IgnGGA/cafProyect01/IMAGE/039_analsisProbelmatica.jpeg

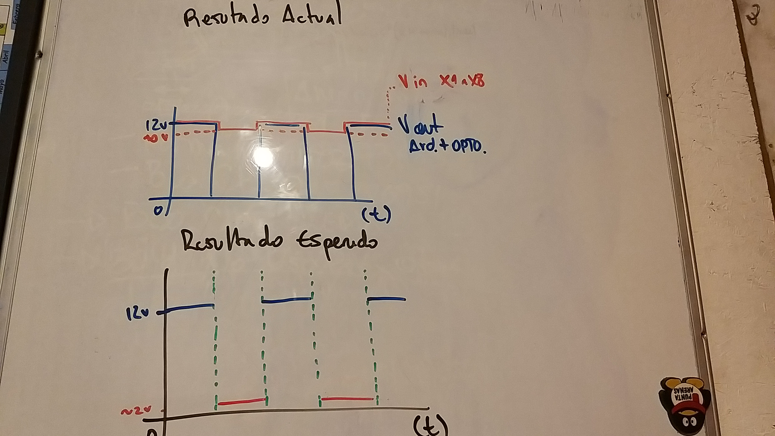
IMAGE/039_analsisProbelmatica.jpeg
