IgnGGA/cafProyect01/EVR_proyecto.pdf

## EVR.CV.VA-X1 EVR.CV.VA-X4 EVR.CV.VA-X5 EVR.CV.VA-X6 EVR.CV.VA-X7 EVR.CV.VA-X8

## Tarjetas internas:

## Ubicación proyecto:

## C:\Users\Ignacio \OneDrive \Documentos\002 _CAF\CAF\Arduino \simPulsosVelocidad_ v2conErrores_v5

Actividad | Status | Actividad | Status
Diseño del programa | 100% | Simulación funcionamiento Placa | 100%
Diseño de la placa | 100% | Placa Impresa y perforada | 100%
Montaje de Componentes | 30% | Funcionamiento de Placa
Desarrollo conexiones VDR | 75% | Montaje de placa en VDR
Funcionamiento | | Modificación_1 | Cambio del Diseño de Placa (versión 2)
Modificación_2 | | Modificación_3

## Revisión

## El Arduino queda pegado y no carga sketch nuevos, probablemente Hayan problemas en el microprocesador que ocasionan problemas en la carga

Sol1: Cambiar Microprocesador.
Sol2: Reemplazar placa completa Arduino.
Sol3: Buscar ayudas y soluciones en foros de internet respecto al error.

De nuevos sketch. (09/04/2021).

## Sol2 fue la última aplicada, la placa se quemó en la comunicación con el computador, por ende no permite modificar el integrado o ver los datos seriales en el computador, la placa solo quedo disponible para arrancar programas sin la necesidad de conectarlo a un computador, es decir, su

funcionamiento caer en solo ejecutar programas sin comunicación alguna.

## Prueba en Protoboard con optoacopladores:

# 001 Registrador de Eventos

8 de abril de 2021 13:14

EVR_proyecto página 1

23/04: los transistores 2N2222 conmutan como corresponde, pero los optoacopladores no realizan dicha acción
tan vez se deba al tipo de componente, su arquitectura u otra característica (PRESENCIA DE CORTE EN PISTA DE TIERRA LO QUE CAUSABA EL ERROR EN EL CIRCUITO).

# 002 Notas de avance

## 23 de abril de 2021 9:38

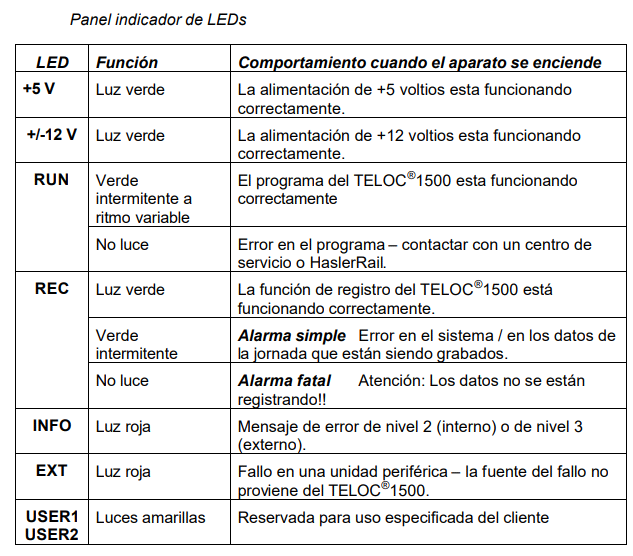
[picture p10: figure]

b4 >>

## z4 << EVR.CV.VA-X11-a3(POSUB)

b2 >>

## z2 << EVR.CV.VA-X11-a3(POSUB) b32(ID0) -- b30(ID_HI)

## EVR.CV.VA-X7

## GND >> tierra b30(GND) >> GND Sensor d28(sig. A) >> Señal Sensor 1 d30(+12v) >> EVR.CV.VA-X1-d6(AN2+) b2(ID1_0) -- z2(ID1_GND) b32(ID2_9) -- z32(ID2_GND)

## EVR.CV.VA-X8

b4 >>

## z4 << EVR.CV.VA-X11-a3(POSUB)

b2 >>

## z2 << EVR.CV.VA-X11-a3(POSUB) d32(ID0) -- b30(ID_HI)

## EVR.CV.VA-X6

## b2(ID1) -- z6(ID_HI)

## EVR.CV.VA-X5

## GND >> tierra d8(AN1+) >> EVR.CV.VA-X1-z10(AN2-) d10(AN1-) >> +12v del Sensor b8(AINI2) -- d10(AINI2-) b4(GND) >> GND Sensor d6(sig. A) >> Señal Sensor 2 d2(ID0) -- z6(ID_HI)

## EVR.CV.VA-X4

## d6(AN2+) << EVR.CV.VA-X8-d30(+12) z10(AN2-) << EVR.CV.VA-X4-d8(AN1+) b6 -- z8 [PUENTE] GND >> tierra z10(GND) >> GND Sensor 3 b8(sig. A) >> Señal Sensor 3 z8(+12v) >> Vcc Sensor 3

z28 >>

## d28 << EVR.CV.VA-X11-a3(POSUB)

z26 >>

## d26 >> EVR.CV.VA-X11-a3(POSUB)

## EVR.CV.VA-X1

## DIJN3--LUZ-DERECHA --CIERRE DE PUERTA DIJNE--LUZ-IZQUIERDA--CC

# 003 Análisis Tarjetas del VDR

## 8 de abril de 2021 15:14

//---
DEFINICION_PINES--------------------------------------------------------------------------------------------------------------------
int pulseOut = 3; | //salida pulsos que simulan velocidad, se selecciona el pin11 por sus
cualidades de salida PWM
int luz = 4; | //indicador que representa LUZ indicadora del TREN
int sirena = 5; | //indicador que representa la SIRENA o GRABACIÓN del tren
int puerta = 6; | //indicador que representa las PUERTAS del TREN
int X1_VT_6 = 10; | //lectura de variable provimiente de tarjeta X1 para rele control de velocidad
6
int X1_VT_05 = 7; | //lectura de variable provimiente de tarjeta X1 para rele control de velocidad
05
int X7_VT_6 =11; | //lectura de variable provimiente de tarjeta X7 para rele control de velocidad
6
int X7_VT_05 = 8; | //lectura de variable provimiente de tarjeta X7 para rele control de velocidad
05
int X6_VT_6 = 12; | //lectura de variable provimiente de tarjeta X6 para rele control de velocidad
6
int X6_VT_05 = 9; | //lectura de variable provimiente de tarjeta X6 para rele control de velocidad
05
int error = 13; | //variable destinada a dar indicación de ERROR a causa de alguna condición
incumplida
//---
DEFINICION_VARIABLES----------------------------------------------------------------------------------------------------------------
int countMax = 1160; | //es 1.25 veces la frecuencia maxima
float tiempo; | //tiempo que estara en funcion de la freciencia
float i, j; | //contadores
float vel; | //valor de la velocidad en funcion de la frecuencia
const float vel_1 = 0.5; | //velocidad para apagar el rele 1
const float vel_2 = 6; | //velocidad para apagar el rele 2
const int z = 100; | //ventanas de la rueda
const float var1 = 0.953; | //diametro de la rueda en metros
const float var2 = 3.6; | //constante de velocidad del TREN
const float var3 = 100; | //ventanas de la rueda

void setup() {
Serial.begin(9600); | //velocidad de lectura y escritura del arduino.
pinMode(pulseOut, OUTPUT);
pinMode(puerta, OUTPUT);
pinMode(luz, OUTPUT);
pinMode(sirena, OUTPUT);
pinMode(X1_VT_6, INPUT); | //se define como entrada para lectura de reaccion del REGISTRADOR
DE EVENTOS
pinMode(X1_VT_05, INPUT); | //se define como entrada para lectura de reaccion del REGISTRADOR
DE EVENTOS
pinMode(X7_VT_6, INPUT);
pinMode(X7_VT_05, INPUT);
pinMode(X6_VT_6, INPUT);
pinMode(X6_VT_05, INPUT);
pinMode(error, OUTPUT);
}

void loop() {
digitalWrite(puerta, HIGH); Serial.println("TREN sale de ESTACIÓN"); acelerar();
Serial.println("VELOCIDAD MAXIMA"); desacelerar();
Serial.println("TREN ha llegado a DESTINO");
enEstacion();
}
//------------FUNCIONES-------------------------------------------------------------------------------//---SALIDA_SEÑAL_CUADRADA----------------------------------------------------------------------------
void senalOut() { | //Funcion que se encarga de generar los estados de los semiciclos
correspondientes.
tiempo = (1000 / (i / (1.25))); //tiempo de duracion de cada semiCiclo en milisegundos digitalWrite(pulseOut, HIGH);
delay(tiempo / 2); | //semiciclo positivo
digitalWrite(pulseOut, LOW);
delay(tiempo / 2); | //semiciclo negativo

}
//---ACELERACION_DEL_TREN-----------------------------------------------------------------------------
void acelerar() {
for (i = 1; i < countMax; i++) { //se calculo que aproximadamente los 928hz se alcanzan los 100km/h senalOut();
velMax();
lecturasEnSubida05();
lecturasEnSubida6();
}
}
//---DESACELERACION_DEL_TREN--------------------------------------------------------------------------void desacelerar() {
for (i = countMax; i >= 1; i--) {
senalOut();

### Cambiar algunas variables globales a locales no funciono, sigue utilizando más del 80% de memoria para dichas variables

# 004 Programa Arduino

8 de abril de 2021 15:16

velMax();
lecturasEnBajada6();
lecturasEnBajada05();
}
}
//---VISUALIZAR_VELOCIDAD-----------------------------------------------------------------------------void velMax() {
vel = ((i / 1.25) * PI * var1 * var2 / z);
Serial.println(vel);
}
//---ACCIONES_EN_ESTACION-----------------------------------------------------------------------------void enEstacion() {
digitalWrite(puerta, LOW);
Serial.println("APERTURA DE PUERTAS");
delay(4500);
digitalWrite(luz, HIGH);
Serial.println("Se enciende indicador Luminoso"); delay(2000);
digitalWrite(sirena, HIGH);
Serial.println("Suena la Sirena");
delay(2500);
digitalWrite(sirena, LOW); Serial.println("Deja de sonal Sirena"); digitalWrite(luz, LOW);
Serial.println("Se apaga luz indicadora"); digitalWrite(puerta, HIGH); Serial.println("CIERRE DE PUERTAS");
delay(1000);
}
//---FUNCIONES_POR_ERRORES----------------------------------------------------------------------------void error_001() { //error 1 cuando X1_VT_05 debiera ser HIGH
Serial.println("");
for (;;) {
digitalWrite(error, HIGH);
delay(500);
digitalWrite(error, LOW);
delay(500);
}
}
void error_002() { //error 2 cuando X1_VT_6 deberia ser HIGH for (;;) {
for (j = 0; j < 2; j++) {
digitalWrite(error, HIGH);
delay(500);
digitalWrite(error, LOW);
delay(500);
}
delay(1000);
}
}
void error_003() { //error 3 cuando X7_VT_05 deberia ser HIGH for (;;) {
for (j = 0; j < 3; j++) {
digitalWrite(error, HIGH);
delay(500);
digitalWrite(error, LOW);
delay(500);
}
delay(1000);
}
}
void error_004() { //error 4 cuando X7_VT_6 deberia ser HIGH for (;;) {
for (j = 0; j < 4; j++) {
digitalWrite(error, HIGH);
delay(500);
digitalWrite(error, LOW);
delay(500);
}
delay(1000);
}
}
void error_005() { //error 5 cuando X6_VT_05 deberia ser HIGH for (;;) {
for (j = 0; j < 5; j++) {
digitalWrite(error, HIGH);
delay(500);
digitalWrite(error, LOW);
delay(500);
}
delay(1000);
}
}
void error_006() { //error 6 cuando X6_VT_6 deberia ser HIGH for (;;) {
for (j = 0; j < 6; j++) {
digitalWrite(error, HIGH);
delay(500);
digitalWrite(error, LOW);
delay(500);
}
delay(1000);

}
}
void error_007() { //error 7 Ninguna lectura cambia for (;;) {
for (j = 0; j = 7; j++) {
digitalWrite(error, HIGH);
delay(500);
digitalWrite(error, LOW);
delay(500);
}
delay(1000);
}
}
//---
LECTURAS----------------------------------------------------------------------------------------------------------------------------- --------------
void lecturasEnSubida05() {
Serial.println(digitalRead(X1_VT_05));
Serial.println(digitalRead(X7_VT_05));
Serial.println(digitalRead(X6_VT_05));
while (vel > vel_1) { | //Cuando la velocidad calculada es MAYOR a 0.5KM/h y...
if (digitalRead(X1_VT_05) == LOW ) { | //Si la lectura es 0 digital, se ejecuta el error 1
Serial.println("ERROR_011: la variable X1_VT_05 debia arrojar un UNO, pero recibio un CERO\nERROR CONTROL DE VELCIDAD RELE 0.5KM/H");
error_001();
break;
}
else if (digitalRead(X7_VT_05) == LOW ) { //Si la lectura es 0 digital, se ejecuta el error 3 Serial.println("ERROR_021: la variable X7_VT_05 debia arrojar un UNO, pero recibio un CERO\nERROR CONTROL DE VELCIDAD RELE 0.5KM/H");
error_003();
break;
}
else if (digitalRead(X6_VT_05) == LOW ) { //Si la lectura es 0 digital, se ejecuta el error 5 Serial.println("ERROR_031: la variable X6_VT_05 debia arrojar un UNO, pero recibio un CERO\nERROR CONTROL DE VELCIDAD RELE 0.5KM/H");
error_005();
break;
}
else{
break;
}
break;
}
}
void lecturasEnSubida6(){
Serial.println(digitalRead(X1_VT_6));
Serial.println(digitalRead(X7_VT_6));
Serial.println(digitalRead(X6_VT_6));
while (vel > vel_2) { | //Cuando la velocidad calculada es MENOR a 6km/h y...
if (digitalRead(X1_VT_6) == LOW) { | //Si la lectura es 1 digital, se ejecuta el error 2
Serial.println("ERROR_012: la variable X1_VT_6 debia arrojar un UNO, pero recibio un CERO\nERROR CONTROL DE VELCIDAD RELE 6KM/H");
error_002();
break;
}
else if (digitalRead(X7_VT_6) == LOW) { | //Si la lectura es 1 digital, se ejecuta el error 4
Serial.println("ERROR_022: la variable X7_VT_6 debia arrojar un UNO, pero recibio un CERO\nERROR CONTROL DE VELCIDAD RELE 6KM/H");
error_004();
break;
}
else if (digitalRead(X6_VT_6) == LOW) { | //Si la lectura es 1 digital, se ejecuta el error 6
Serial.println("ERROR_032: la variable X6_VT_6 debia arrojar un UNO, pero recibio un CERO\nERROR CONTROL DE VELCIDAD RELE 6KM/H");
error_006();
break;
}
else{
break;
}
break;
}
}
void lecturasEnBajada05() { Serial.println(digitalRead(X1_VT_05));
Serial.println(digitalRead(X7_VT_05));
Serial.println(digitalRead(X6_VT_05));
while (vel <= vel_1) { | //Si la velocidad calculada es MENOR a 0.5KM/h y...
if (digitalRead(X1_VT_05) == HIGH ) { | //Si la lectura es 1 digital, se ejecuta el error 1
Serial.println("ERROR_013: la variable X1_VT_05 debia arrojar un CERO, pero recibio un UNO\nERROR CONTROL DE VELCIDAD RELE 0.5KM/H");
error_001();
break;
}
else if (digitalRead(X7_VT_05) == HIGH ) { | //Si la lectura es 1 digital, se ejecuta el error 3
Serial.println("ERROR_023: la variable X7_VT_05 debia arrojar un CERO, pero recibio un UNO\nERROR CONTROL DE VELCIDAD RELE 0.5KM/H");
error_003();
break;
}
else if (digitalRead(X6_VT_05) == HIGH ) { | //Si la lectura es 1 digital, se ejecuta el error 5

Serial.println("ERROR_033: la variable X6_VT_05 debia arrojar un CERO, pero recibio un UNO\nERROR CONTROL DE VELCIDAD RELE 0.5KM/H");
error_005();
break;
}
else{
break;
}
break;
}
}
void lecturasEnBajada6(){
Serial.println(digitalRead(X1_VT_6));
Serial.println(digitalRead(X7_VT_6));
Serial.println(digitalRead(X6_VT_6));
while (vel <= vel_2) { | //Si la velocidad calculada es MENOR a 6km/h y...
if (digitalRead(X1_VT_6) == HIGH) { | //Si la lectura es 1 digital, se ejecuta el error 2
Serial.println("ERROR_014: la variable X1_VT_6 debia arrojar un CERO, pero recibio un UNO\nERROR CONTROL DE VELCIDAD RELE 6KM/H");
error_002();
break;
}
else if (digitalRead(X7_VT_6) == HIGH) { | //Si la lectura es 1 digital, se ejecuta el error 2
Serial.println("ERROR_024: la variable X7_VT_6 debia arrojar un CERO, pero recibio un UNO\nERROR CONTROL DE VELCIDAD RELE 6KM/H");
error_004();
break;
}
else if (digitalRead(X6_VT_6) == HIGH) { | //Si la lectura es 1 digital, se ejecuta el error 2
Serial.println("ERROR_034: la variable X6_VT_6 debia arrojar un CERO, pero recibio un UNO\nERROR CONTROL DE VELCIDAD RELE 6KM/H");
error_006();
break;
}
else{
break;
}
break;
}
}
//---NOTAS--------------------------------------------------------------------------------------------
//considerar que la grafica de velocidad que se dibuja (o comprende) es lineal, por lo tanto, su aceleración es constante mientras que a travez
//de una ecuacion de posición en funcion del tiempo es parabolico, esto considerando el M.R.U.A. (movimiento rectilineo uniforme acelerado).
//El tiempo aproximado desde la salida del tren hasta la llegada a la estacion toma aproximadamente 1:09 minutos.
//Se cambio la proporcion de la frecuencia de 2.5 a 1.25 veces la frecuencia, esto debido a que el programa toma mas tiempo en las iteraciones.
//los casos de errores evalua una tarjeta a la vez, queda pendiente versionar casos de pruebas para multiples combinaciones de tarjetas.

//---
DEFINICION_PINES--------------------------------------------------------------------------------------------------------------------

# int error = 2; //variable destinada a dar indicación de ERROR a causa de alguna condición incumplida

int pulseOut = 3; //salida pulsos que simulan velocidad, se selecciona el pin11 por sus cualidades de

# salida PWM

int cc = 4; | //Confirmación Cierre de Puertas.
int luz = 5; | //indicador que representa LUZ indicadora del TREN

# int sirena = 6; //indicador que representa la SIRENA o GRABACIÓN del tren int puerta = 7; //indicador que representa las PUERTAS del TREN

int X1_VT_6 = 8; //lectura de variable provimiente de tarjeta X1 para rele control de velocidad 6 int X7_VT_6 = 9; //lectura de variable provimiente de tarjeta X7 para rele control de velocidad 6 int X6_VT_6 = 10; //lectura de variable provimiente de tarjeta X6 para rele control de velocidad 6 int X1_VT_05 = 11; //lectura de variable provimiente de tarjeta X1 para rele control de velocidad 05 int X7_VT_05 = 12; //lectura de variable provimiente de tarjeta X7 para rele control de velocidad 05 int X6_VT_05 = 13; //lectura de variable provimiente de tarjeta X6 para rele control de velocidad 05 //---
DEFINICION_VARIABLES----------------------------------------------------------------------------------------------------------------
int countMax = 1160; | //es 1.25 veces la frecuencia maxima
float tiempo; | //tiempo que estara en funcion de la freciencia
float i, j; | //contadores
float vel; | //valor de la velocidad en funcion de la frecuencia

const float vel_1 = 0.5; //velocidad para apagar el rele 1 const float vel_2 = 6; //velocidad para apagar el rele 2 const float var1 = 0.953; //diametro de la rueda en metros const float var2 = 3.6; //constante de velocidad del TREN const float var3 = 100; //ventanas de la rueda const float var4 = 1.25; //Cantidad de veces que se multiplico la frecuencia maxima

# void setup()

{
Serial.begin(9600); //velocidad de lectura y escritura del arduino. pinMode(pulseOut, OUTPUT);
pinMode(puerta, OUTPUT);
pinMode(luz, OUTPUT);
pinMode(sirena, OUTPUT);
pinMode(X1_VT_6, INPUT); //se define como entrada para lectura de reaccion del REGISTRADOR

# DE EVENTOS

pinMode(X1_VT_05, INPUT); //se define como entrada para lectura de reaccion del REGISTRADOR

# DE EVENTOS

pinMode(X7_VT_6, INPUT);
pinMode(X7_VT_05, INPUT);
pinMode(X6_VT_6, INPUT);
pinMode(X6_VT_05, INPUT);
pinMode(error, OUTPUT);

# pinMode(A0, OUTPUT); //Se usaran las entradas analogicas como salidas digitales

pinMode(A1, OUTPUT);
pinMode(A2, OUTPUT);
pinMode(A3,OUTPUT);

# 0041 Programa Arduino (Actual)

## 26 de abril de 2021 13:17

}

# void loop()

{
digitalWrite(cc, LOW);
enEstacion();
Serial.println("TREN sale de ESTACIÓN"); acelerar();
Serial.println("VELOCIDAD MAXIMA"); desacelerar();
Serial.println("TREN ha llegado a DESTINO");
}
//------------FUNCIONES-------------------------------------------------------------------------------//---SALIDA_SEÑAL_CUADRADA----------------------------------------------------------------------------

# void senalOut()

{ | //Funcion que se encarga de generar los estados de los semiciclos
correspondientes.
| tiempo = (1000 / (i / (var4))); //tiempo de duracion de cada semiCiclo en milisegundos
| digitalWrite(pulseOut, HIGH);
| delay(tiempo / 2); //semiciclo positivo
| digitalWrite(pulseOut, LOW);
| delay(tiempo / 2); //semiciclo negativo
}
//---ACELERACION_DEL_TREN-----------------------------------------------------------------------------

# void acelerar()

{
| for (i = 1; i < countMax; i++)
| { //se calculo que aproximadamente los 928hz se alcanzan los 100km/h
senalOut();
velMax();
| lecturasEnSubida05();
| lecturasEnSubida6();
}
}
//---DESACELERACION_DEL_TREN--------------------------------------------------------------------------

# void desacelerar()

{
| for (i = countMax; i >= 1; i--)
{
senalOut();
velMax();
| lecturasEnBajada6();
| lecturasEnBajada05();
}
}
//---VISUALIZAR_VELOCIDAD-----------------------------------------------------------------------------

# void velMax()

{
| vel = ((i / var4) * PI * var1 * var2 / var3);
Serial.println(vel);
}
//---ACCIONES_EN_ESTACION-----------------------------------------------------------------------------

# void enEstacion()

{
| digitalWrite(puerta, LOW);
| Serial.println("APERTURA DE PUERTAS");
delay(4500);

digitalWrite(luz, HIGH);
Serial.println("Se enciende indicador Luminoso"); delay(2000);
digitalWrite(sirena, HIGH);
Serial.println("Suena la Sirena");
delay(2500);
digitalWrite(sirena, LOW); Serial.println("Deja de sonal Sirena"); digitalWrite(luz, LOW);
Serial.println("Se apaga luz indicadora"); digitalWrite(puerta, HIGH); Serial.println("CIERRE DE PUERTAS"); digitalWrite(cc, HIGH);
delay(1000);
}
//---FUNCIONES_POR_ERRORES----------------------------------------------------------------------------

# void error_001() { //error 1 cuando X1_VT_05 debiera ser HIGH

Serial.println("");

# for (;;)

{
digitalWrite(error, HIGH); delay(500);
digitalWrite(error, LOW);
delay(500);
}
}

# void error_002() { //error 2 cuando X1_VT_6 deberia ser HIGH for (;;)

{

# for (j = 0; j < 2; j++)

{
digitalWrite(error, HIGH); delay(500);
digitalWrite(error, LOW);
delay(500);
}
delay(1000);
}
}

# void error_003() { //error 3 cuando X7_VT_05 deberia ser HIGH for (;;)

{

# for (j = 0; j < 3; j++)

{
digitalWrite(error, HIGH); delay(500);
digitalWrite(error, LOW);
delay(500);
}
delay(1000);
}
}

# void error_004() { //error 4 cuando X7_VT_6 deberia ser HIGH

# for (;;)

{

# for (j = 0; j < 4; j++)

{
digitalWrite(error, HIGH); delay(500);
digitalWrite(error, LOW);
delay(500);
}
delay(1000);
}
}

# void error_005() { //error 5 cuando X6_VT_05 deberia ser HIGH for (;;)

{

# for (j = 0; j < 5; j++)

{
digitalWrite(error, HIGH); delay(500);
digitalWrite(error, LOW);
delay(500);
}
delay(1000);
}
}

# void error_006() { //error 6 cuando X6_VT_6 deberia ser HIGH for (;;)

{

# for (j = 0; j < 6; j++)

{
digitalWrite(error, HIGH); delay(500);
digitalWrite(error, LOW);
delay(500);
}
delay(1000);
}
}

# void error_007() { //error 7 Ninguna lectura cambia for (;;)

{

# for (j = 0; j = 7; j++)

{
digitalWrite(error, HIGH); delay(500);
digitalWrite(error, LOW);
delay(500);
}
delay(1000);
}
}
//---
LECTURAS-------------------------------------------------------------------------------------------------------------------------------------------

# void lecturasEnSubida05()

{
Serial.println(digitalRead(X1_VT_05)); Serial.println(digitalRead(X7_VT_05)); Serial.println(digitalRead(X6_VT_05));

# while (vel > vel_1)

{ //Cuando la velocidad calculada es MAYOR a 0.5KM/h y...

# if (digitalRead(X1_VT_05) == HIGH) { //Si la lectura es 0 digital, se ejecuta el error 1

digitalWrite(A0,HIGH);
digitalWrite(A1,LOW);
digitalWrite(A2,LOW);
digitalWrite(A3,LOW);
Serial.println("ERROR_011: la variable X1_VT_05 debia arrojar un UNO, pero recibio un CERO \nERROR CONTROL DE VELCIDAD RELE 0.5KM/H");
error_001();
break;
}

# else if (digitalRead(X7_VT_05) == HIGH) { //Si la lectura es 0 digital, se ejecuta el error 3

digitalWrite(A0,LOW);
digitalWrite(A1,HIGH);
digitalWrite(A2,LOW);
digitalWrite(A3,LOW);
Serial.println("ERROR_021: la variable X7_VT_05 debia arrojar un UNO, pero recibio un CERO \nERROR CONTROL DE VELCIDAD RELE 0.5KM/H");
error_003();
break;
}

# else if (digitalRead(X6_VT_05) == HIGH) { //Si la lectura es 0 digital, se ejecuta el error 5

digitalWrite(A0,HIGH);
digitalWrite(A1,HIGH);
digitalWrite(A2,LOW);
digitalWrite(A3,LOW);
Serial.println("ERROR_031: la variable X6_VT_05 debia arrojar un UNO, pero recibio un CERO \nERROR CONTROL DE VELCIDAD RELE 0.5KM/H");
error_005();
break;
}

# else

{
break;
}
break;
}
}

# void lecturasEnSubida6()

{
Serial.println(digitalRead(X1_VT_6)); Serial.println(digitalRead(X7_VT_6)); Serial.println(digitalRead(X6_VT_6));

# while (vel > vel_2)

{ //Cuando la velocidad calculada es MENOR a 6km/h y...

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

# aceleración es constante mientras que a travez

//de una ecuacion de posición en funcion del tiempo es parabolico, esto considerando el M.R.U.A. (movimiento rectilineo uniforme acelerado).

# //El tiempo aproximado desde la salida del tren hasta la llegada a la estacion toma

aproximadamente 1:09 minutos.
//Se cambio la proporcion de la frecuencia de 2.5 a 1.25 veces la frecuencia, esto debido a que el programa toma mas tiempo en las iteraciones.
//los casos de errores evalua una tarjeta a la vez, queda pendiente versionar casos de pruebas para multiples combinaciones de tarjetas.

# 005 Proteus

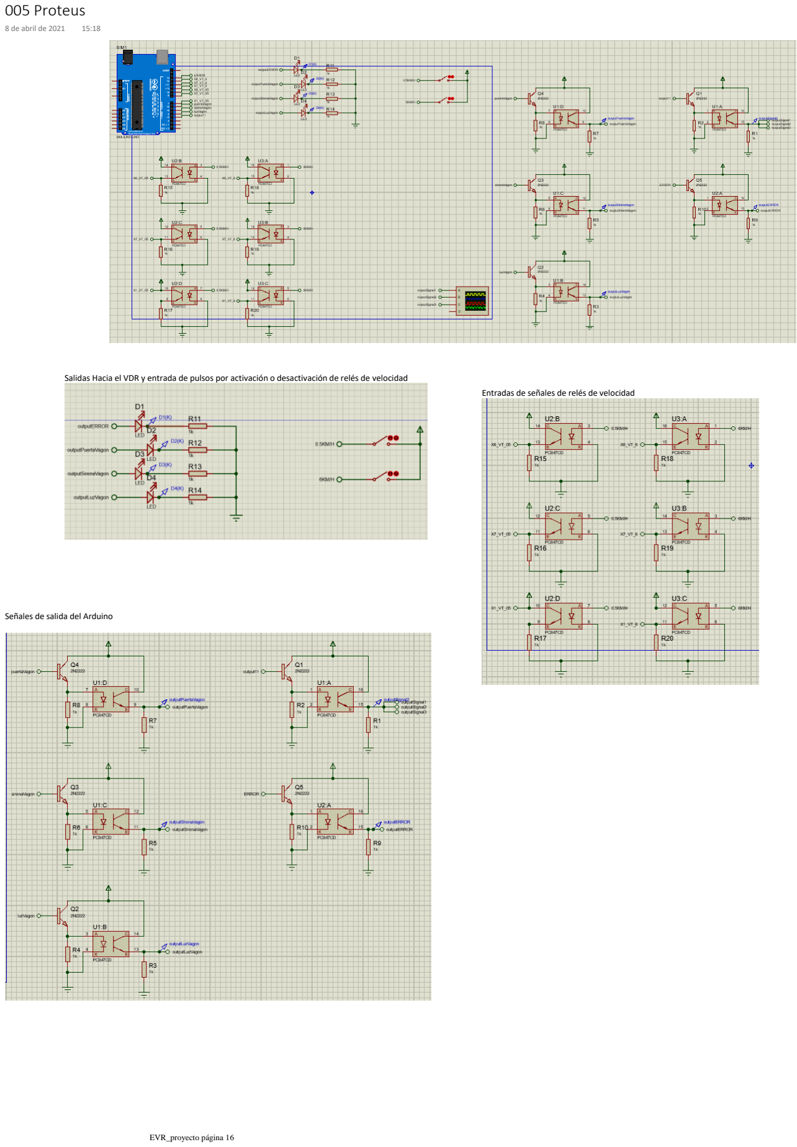
[picture p11: page 16]

Salidas Hacia el VDR y entrada de pulsos por activación o desactivación de relés de velocidad Entradas de señales de relés de velocidad

Señales de salida del Arduino

8 de abril de 2021 15:18

## 006 Diseño PCB

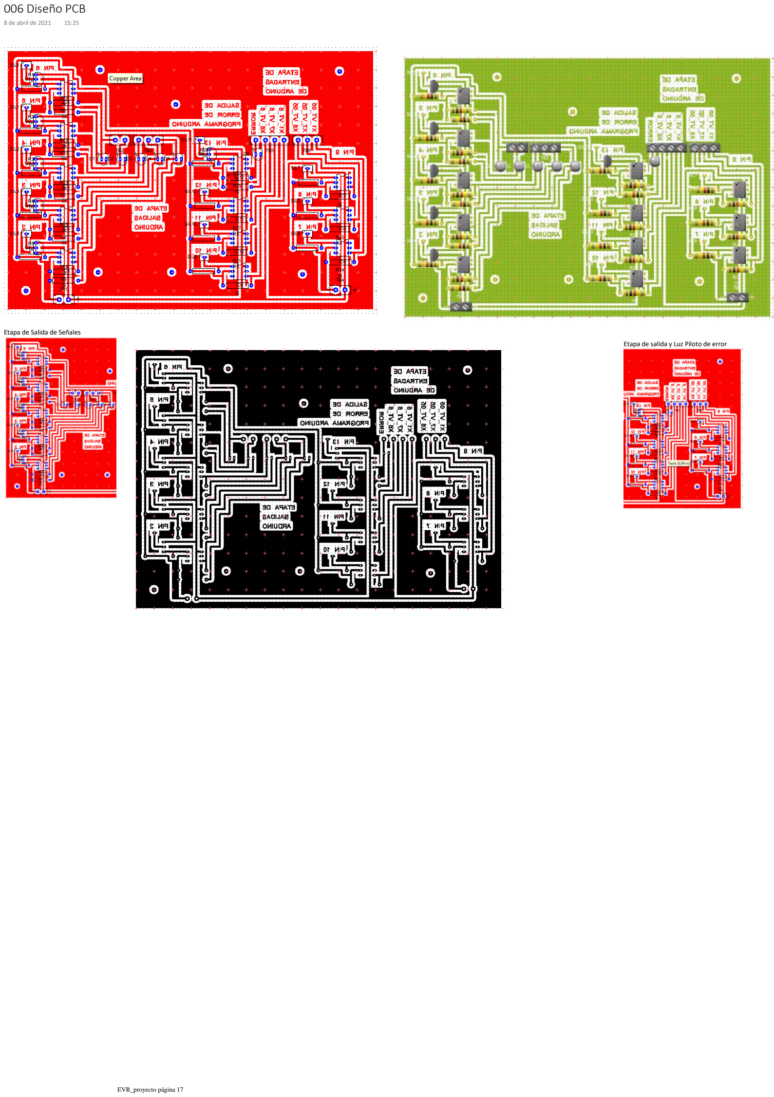
[picture p12: page 17]

Etapa de Salida de Señales Etapa de salida y Luz Piloto de error

8 de abril de 2021 15:25

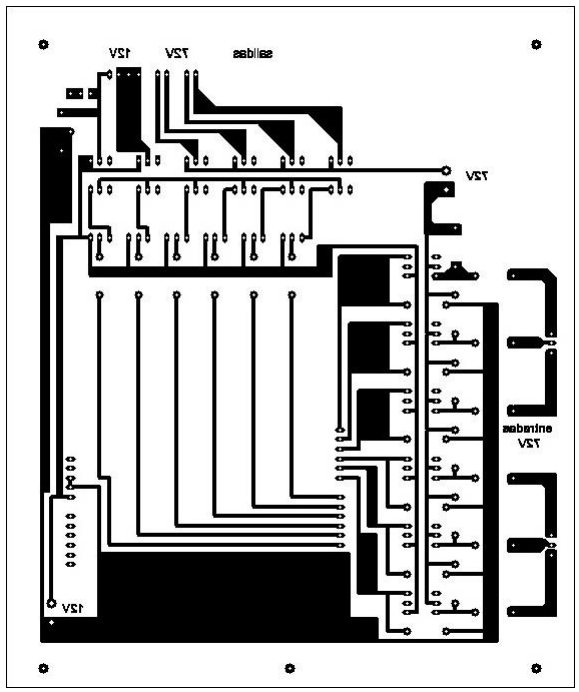
[picture p13: figure]

Detalle: Falta relacionar las tierras, de los optoacopladores en la etapa de salida y la tierra de la etapa de control (+12V).

# 0061 Diseño PCB (Actual)

## 26 de abril de 2021 13:08

### Estará condicionado por la respuesta del Arduino… ¿Qué respuesta necesito por parte del Arduino para saber que error proyectar? ¿Qué necesito que reciba el pic para proyectar el error?

### Proyectar mensaje de error dependiendo de qué y en qué momento…

Actividad | Estatus | Solución/problema
Programa para PIC 16F628A | ok
Prueba Simulación Display | ok
Carga de programa en PIC FISICO | Ok | Utilización de PICKIT3 programer para subir el programa
Prueba del sistema | Ok | El programa aunque aparentemente está cargado, no se ejecuta al energizar. Sol: problemas de alimentación, el programa se ejecuta sin problemas y responde a los estímulos establecidos

### Diseño de PCB/ Impresión/ Montaje

Prueba en conjunto Arduino | | Funciona correctamente según las combinaciones provenientes del ARDUINO. En primera fase.

# 007 ¿Qué hacer con el pic 16f628A?

14 de abril de 2021 11:01

#include <16F628A.h>

#use delay(clock = 4000000) | /* OSCILADOR INTERNO */ | //No aplica, ya que se activo el cristal interno

#FUSES NOWDT | /* No Watch Dog Timer*/

//#FUSES HS | /* High speed Osc (> 4mhz)*/ | //Se usa con un cristal mayor al de 4Mhz, se
recomienda usar el cristal interno
#FUSES PUT | /* Power Up Timer*/

#FUSES NOPROTECT | /* Code not protected from reading*/

#FUSES NOBROWNOUT | /* No brownout reset*/

#FUSES NOMCLR | /* Master Clear pin disabled*/

#FUSES NOLVP | /* No low voltage prgming, B3(PIC16) or B5(PIC18) used for I/O*/

#FUSES NOCPD

#FUSES INTRC | //Activacion uso cristal interno

#include <lcd.c> | /*libreria para usar el lcd*/

#define LCD_ENABLE_PIN PIN_B0 /* ASIGNAMOS EL PIN "B0" COMO SALIDA PARA E */ #define LCD_RS_PIN PIN_B1 /* ASIGNAMOS EL PIN "B1" COMO SALIDA PARA RS*/ #define LCD_RW_PIN PIN_B2 /* ASIGNAMOS EL PIN "B2" COMO SALIDA PARA RW*/

#define LCD_DATA4 PIN_B4 | /* ASIGNAMOS EL PIN "B4" COMO SALIDA PARA D4*/

#define LCD_DATA5 PIN_B5 | /* ASIGNAMOS EL PIN "B5" COMO SALIDA PARA D5*/

#define LCD_DATA6 PIN_B6 | /* ASIGNAMOS EL PIN "B6" COMO SALIDA PARA D6*/

#define LCD_DATA7 PIN_B7 | /* ASIGNAMOS EL PIN "B7" COMO SALIDA PARA D7*/

void main() {

output_high(pin_a4);
delay_ms(500);
output_low(pin_a4);
lcd_init();
lcd_putc("

\f");
do{
lcd_gotoxy(1,1);
printf(lcd_putc,"Esperando ERROR"); lcd_gotoxy(1,2);
printf(lcd_putc, "Registrador de Eventos");
//funcion de arduino lecturasEnSubida05
if (input(PIN_A0) == 1 && input(PIN_A1)==0 && input(PIN_A2)==0 && input(PIN_A3)==0) {
| lcd_putc(" \f"); lcd_gotoxy(1,1); printf(lcd_putc, "Error en:"); lcd_gotoxy(1,2); printf(lcd_putc,"ERROR_011: la variable X1_VT_05"); break;

}
else if (input(PIN_A0) == 0 && input(PIN_A1)==1 && input(PIN_A2)==0 && input(PIN_A3)==0) {
| lcd_putc(" \f"); lcd_gotoxy(1,1); printf(lcd_putc, "Error en:"); lcd_gotoxy(1,2); printf(lcd_putc, "ERROR_021: la variable X7_VT_05"); break;

}
else if (input(PIN_A0) == 1 && input(PIN_A1)==1 && input(PIN_A2)==0 && input(PIN_A3)==0) {
| lcd_putc(" \f"); lcd_gotoxy(1,1); printf(lcd_putc, "Error en:"); lcd_gotoxy(1,2); printf(lcd_putc, "ERROR_031: la variable X6_VT_05"); break;

}
//funcion de arduino lecturasEnSubida6
else if (input(PIN_A0) == 0 && input(PIN_A1)==0 && input(PIN_A2)==1 && input(PIN_A3)==0) {
| lcd_putc(" \f"); lcd_gotoxy(1,1); printf(lcd_putc, "Error en:"); lcd_gotoxy(1,2); printf(lcd_putc,"ERROR_012: la variable X1_VT_6"); break;

}
else if (input(PIN_A0) == 1 && input(PIN_A1)==0 && input(PIN_A2)==1 && input(PIN_A3)==0) {
| lcd_putc(" \f"); lcd_gotoxy(1,1); printf(lcd_putc, "Error en:"); lcd_gotoxy(1,2); printf(lcd_putc, "ERROR_022: la variable X7_VT_6"); break;

}
else if (input(PIN_A0) == 0 && input(PIN_A1)==1 && input(PIN_A2)==1 && input(PIN_A3)==0) {
| lcd_putc(" \f"); lcd_gotoxy(1,1); printf(lcd_putc, "Error en:"); lcd_gotoxy(1,2); printf(lcd_putc, "ERROR_032: la variable X6_VT_6"); break;

}
//funcion de arduino lecturasEnBajada05
else if (input(PIN_A0) == 1 && input(PIN_A1)==1 && input(PIN_A2)==1 && input(PIN_A3)==0) {
| lcd_putc(" \f"); lcd_gotoxy(1,1); printf(lcd_putc, "Error en:"); lcd_gotoxy(1,2);

:1000000002308A00D22A0000
0A108A100A118207E0
:1000100028340C3401340634
0A108A100A1182077D
:100020000C3400340A108A10
0A11820745347334E4
:100030007034653472346134
6E3464346F34203417
:100040004534523452344F34
523400340A108A103A
:100050000A11820752346534
673469347334743456
:100060007234613464346F34
7234203464346534EF
:100070002034453476346534
6E3474346F347334DC
:1000800000340A108A100A11
82074534723472341F
:100090006F34723420346534
6E343A3400340A10CC
:1000A0008A100A1182074534
523452344F34523484
:1000B0005F34303431343134
3A3420346C34613488
:1000C0002034763461347234
6934613462346C348F
:1000D0006534203458343134
5F34563454345F340A
:1000E0003034353400340A10
8A100A11820745343E
:1000F000523452344F345234
5F3430343234313429
:100100003A3420346C346134
2034763461347234BF
:100110006934613462346C34
653420345834373493
:100120005F34563454345F34
3034353400340A107C
:100130008A100A1182074534
523452344F345234F3
:100140005F34303433343134
3A3420346C346134F5
:100150002034763461347234
6934613462346C34FE
:100160006534203458343634
5F34563454345F3474
:100170003034353400340A10
8A100A1182074534AD
:10018000523452344F345234
5F3430343134323498
:100190003A3420346C346134
20347634613472342F
:1001A0006934613462346C34
653420345834313409
:1001B0005F34563454345F34
363400340A108A10B5
:1001C0000A11E53E03188A0A
82004534523452343B
:1001D0004F3452345F343034
323432343A34203491
:1001E0006C34613420347634
61347234693461346F
:1001F00062346C3465342034
583437345F345634C8
:1002000054345F3436340034
0A148A100A118207D9
:100210004534523452344F34
52345F3430343334F2
:1002200032343A3420346C34
6134203476346134DE
:100230007234693461346234
6C3465342034583437
:1002400036345F3456345434
5F34363400340A1450
:100250008A100A1182074534
523452344F345234D2
:100260005F34303431343334
3A3420346C346134D4
:100270002034763461347234
6934613462346C34DD
:100280006534203458343734
5F34563454345F3452
:100290003034353400340A14
8A100A118207453488
:1002A000523452344F345234
5F3430343234333475
:1002B0003A3420346C346134
20347634613472340E
:1002C0006934613462346C34
6534203458343734E2
:1002D0005F34563454345F34
3034353400340A14C7
:1002E0008A100A1182074534
523452344F34523442
:1002F0005F34303433343334
3A3420346C34613442
:100300002034763461347234
6934613462346C344C
:100310006534203458343634
5F34563454345F34C2
:100320003034353400340A14

# 008 Programa PIC

16 de abril de 2021 9:36

{
lcd_putc("

\f");
lcd_gotoxy(1,1);
printf(lcd_putc, "Error en:");
lcd_gotoxy(1,2);
printf(lcd_putc, "ERROR_013: la variable X7_VT_05");
break;
}
else if (input(PIN_A0) == 0 && input(PIN_A1)==0 && input(PIN_A2)==0 && input(PIN_A3)==1) {
lcd_putc("

\f");
lcd_gotoxy(1,1);
printf(lcd_putc, "Error en:");
lcd_gotoxy(1,2);
printf(lcd_putc,"ERROR_023: la variable X7_VT_05");
break;
}
else if (input(PIN_A0) == 1 && input(PIN_A1)==0 && input(PIN_A2)==0 && input(PIN_A3)==1) {
lcd_putc("

\f");
lcd_gotoxy(1,1);
printf(lcd_putc, "Error en:");
lcd_gotoxy(1,2);
printf(lcd_putc,"ERROR_033: la variable X6_VT_05"); break;
}
//funcion de arduino lecturasEnBajadas6
else if (input(PIN_A0) == 0 && input(PIN_A1)==1 && input(PIN_A2)==0 && input(PIN_A3)==1) {
lcd_putc("

\f");
lcd_gotoxy(1,1);
printf(lcd_putc, "Error en:");
lcd_gotoxy(1,2);
printf(lcd_putc, "ERROR_014: la variable X7_VT_6");
break;
}
else if (input(PIN_A0) == 1 && input(PIN_A1)==1 && input(PIN_A2)==0 && input(PIN_A3)==1) {
lcd_putc("

\f");
lcd_gotoxy(1,1);
printf(lcd_putc, "Error en:");
lcd_gotoxy(1,2);
printf(lcd_putc,"ERROR_024: la variable X7_VT_6");
break;
}
else if (input(PIN_A0) == 0 && input(PIN_A1)==0 && input(PIN_A2)==1 && input(PIN_A3)==1) {
lcd_putc("

\f");
lcd_gotoxy(1,1);
printf(lcd_putc, "Error en:");
lcd_gotoxy(1,2);
printf(lcd_putc,"ERROR_034: la variable X6_VT_6"); break;
}
}while(true); }

3A3420346C34613442
:100300002034763461347234
6934613462346C344C
:100310006534203458343634
5F34563454345F34C2
:100320003034353400340A14
8A100A1182074534F7
:10033000523452344F345234
5F34303431343434E4
:100340003A3420346C346134
20347634613472347D
:100350006934613462346C34
653420345834373451
:100360005F34563454345F34
363400340A148A10FF
:100370000A11820745345234
52344F3452345F34B8
:100380003034323434343A34
20346C3461342034F0
:100390007634613472346934
613462346C34653477
:1003A0002034583437345F34
563454345F34363460
:1003B00000340A148A100A11
820745345234523428
:1003C0004F3452345F343034
333434343A3420349C
:1003D0006C34613420347634
61347234693461347D
:1003E00062346C3465342034
583436345F345634D7
:1003F00054345F3436340034
2330840083130008CF
:100400000319102A0130F800
F701F70B052AF80B41
:10041000042A4A30F700F70B
0B2A0E2A800B022A17
:1004200008002A0EF039F700
0F3006057704860021
:10043000000006141B2A0610
08000608F700060E26
:100440000F39F80008008316
061086100611831273
:1004500086100F3083160605
F038860083120615C5
:100460000000061400001D22
7808AA0006100000F3
:10047000061400001D227808
A90006100F3083160C
:100480000605860083122A0E
F700F030F70577087C
:100490002904F8007808A900
A91B292A271C86101E
:1004A0002718861400000611
00000610280EA90067
:1004B0000F30A9052908AA00
112228080F39A90020
:1004C000AA00112208000F30
8316060586000610C8
:1004D0008610061183128610
061106100F30A30035
:1004E000FC210130A1002108
033C031C7F2A0330BA
:1004F000AA0011220530A300
FC21A10A732A0230B0
:10050000AA0011220530A300
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
:100BD000A10121084120A10A
F700A200A6220930A4
:100BE0002102031DE92D0130
A3000230A40094224C
:100BF000A1012108D921A10A
F700A200A6221E30D6
:0C0C00002102031DF92D052E
F22A6300CD
:02400E00113F60
:00000001FF
;PIC16F628A
;CRC=EC14 CREATED="16
abr.

-21 08:52"

# 009 Proteus PIC

16 de abril de 2021 9:38

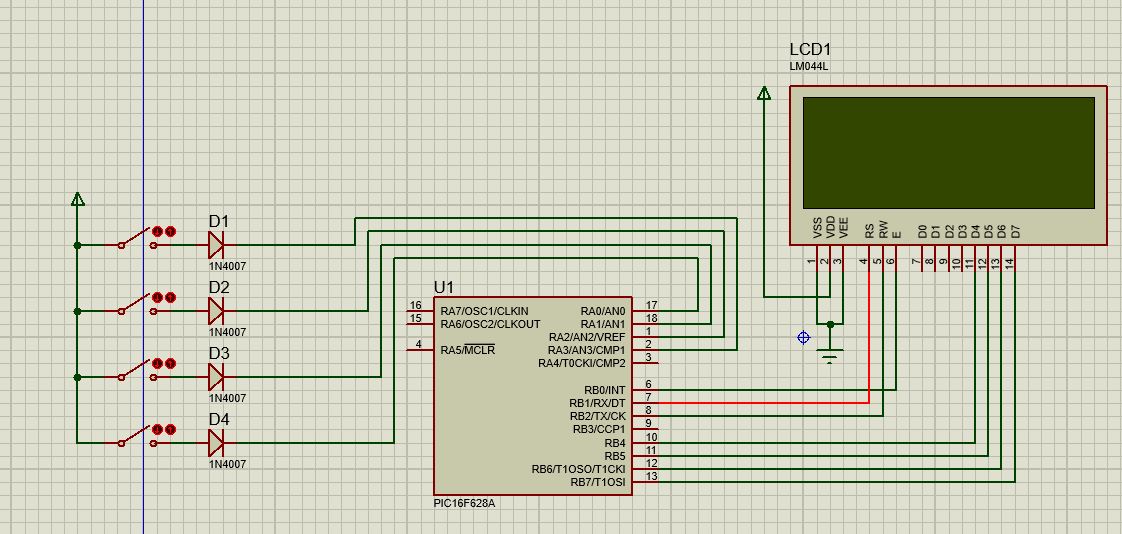
[picture p14: figure]

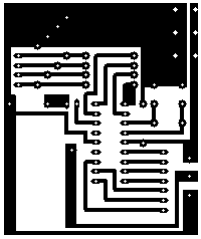
[picture p15: figure]

# Detalle: Las conexiones de b0,b1,b2 y b3 están erroneas, corregirlas si se piensa utilizar este diseño

# 010 Diseño placa Display

## 16 de abril de 2021 11:15

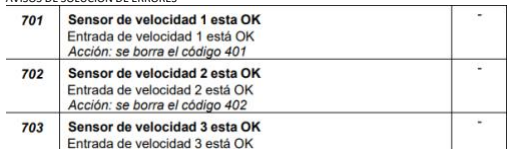
[picture p16: figure]

ERRORES CON LOS QUE NOS PODRIAMOS ENCONTRAR:

AVISOS DE SOLUCION DE ERRORES 011 Posibles errores

26 de abril de 2021 10:55

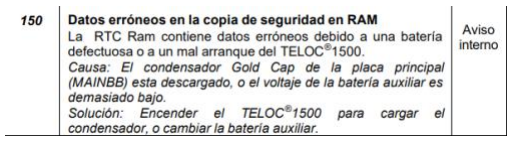
[picture p17: figure]
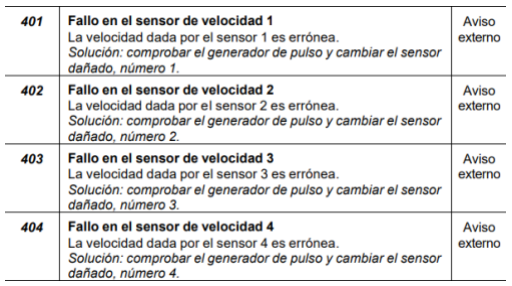
[picture p18: figure]
