IgnGGA/cafProyect01/paraDiseñoPCB/simuladorPulsos/deseño version definitiva.pdf

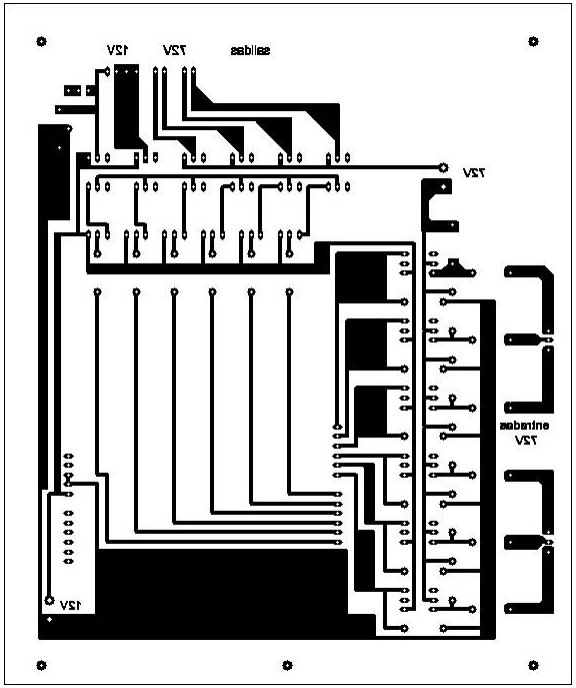
[picture p19: figure]
