IgnGGA/cafProyect01/paraDiseñoPCB/display/placaParaImprimir.pdf

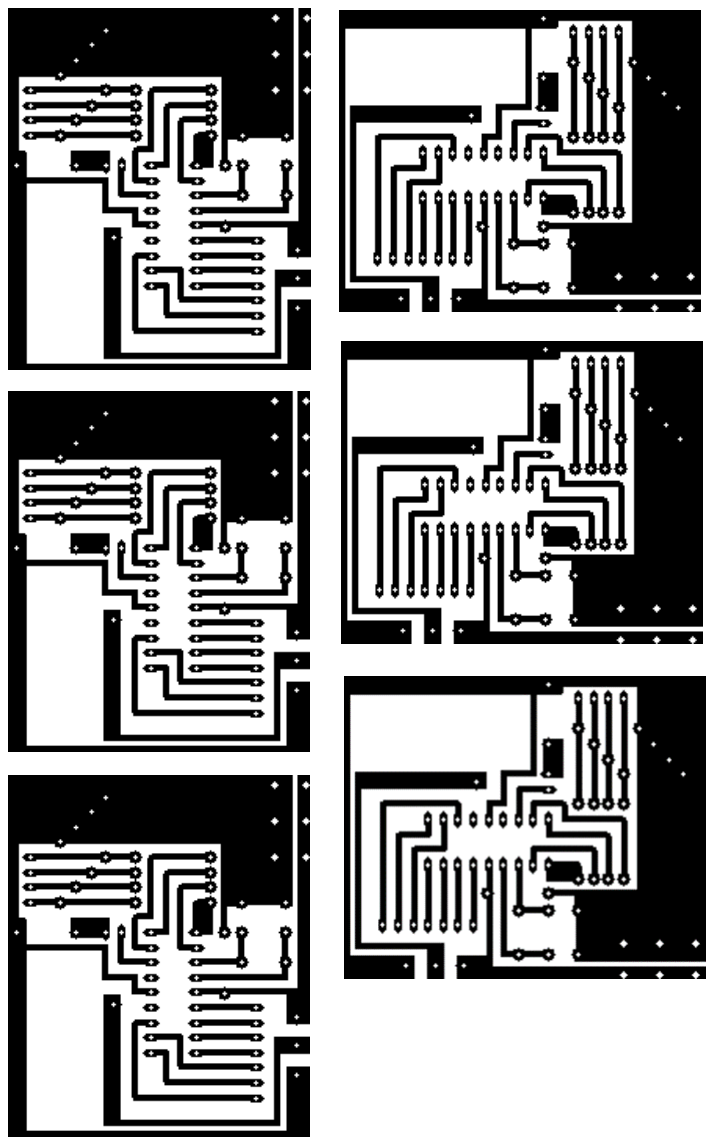
[picture p20: page 1]
