IgnGGA/cafProyect01/paraDiseñoPCB/simuladorPulsos/diseñoVersion03.pdf

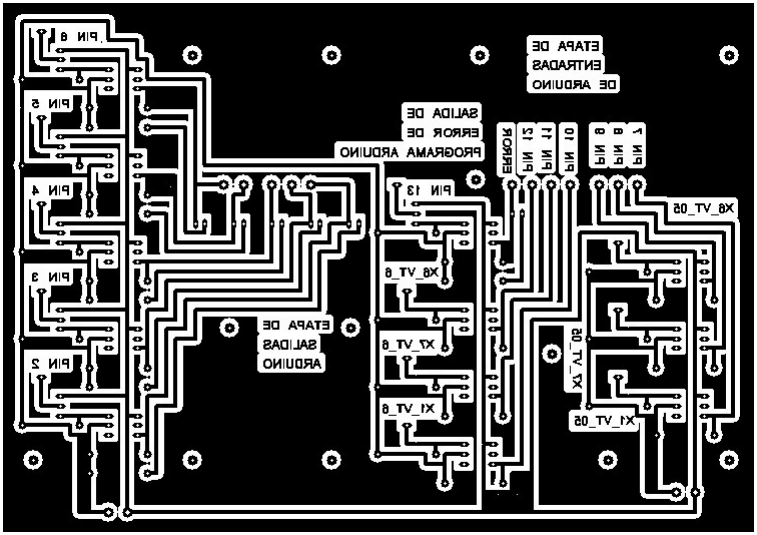
[picture p21: figure]
