IgnGGA/cafProyect01/Info/planos/C.C8.65.171_H1_--+++CONTROL_VELOCIDAD.pdf

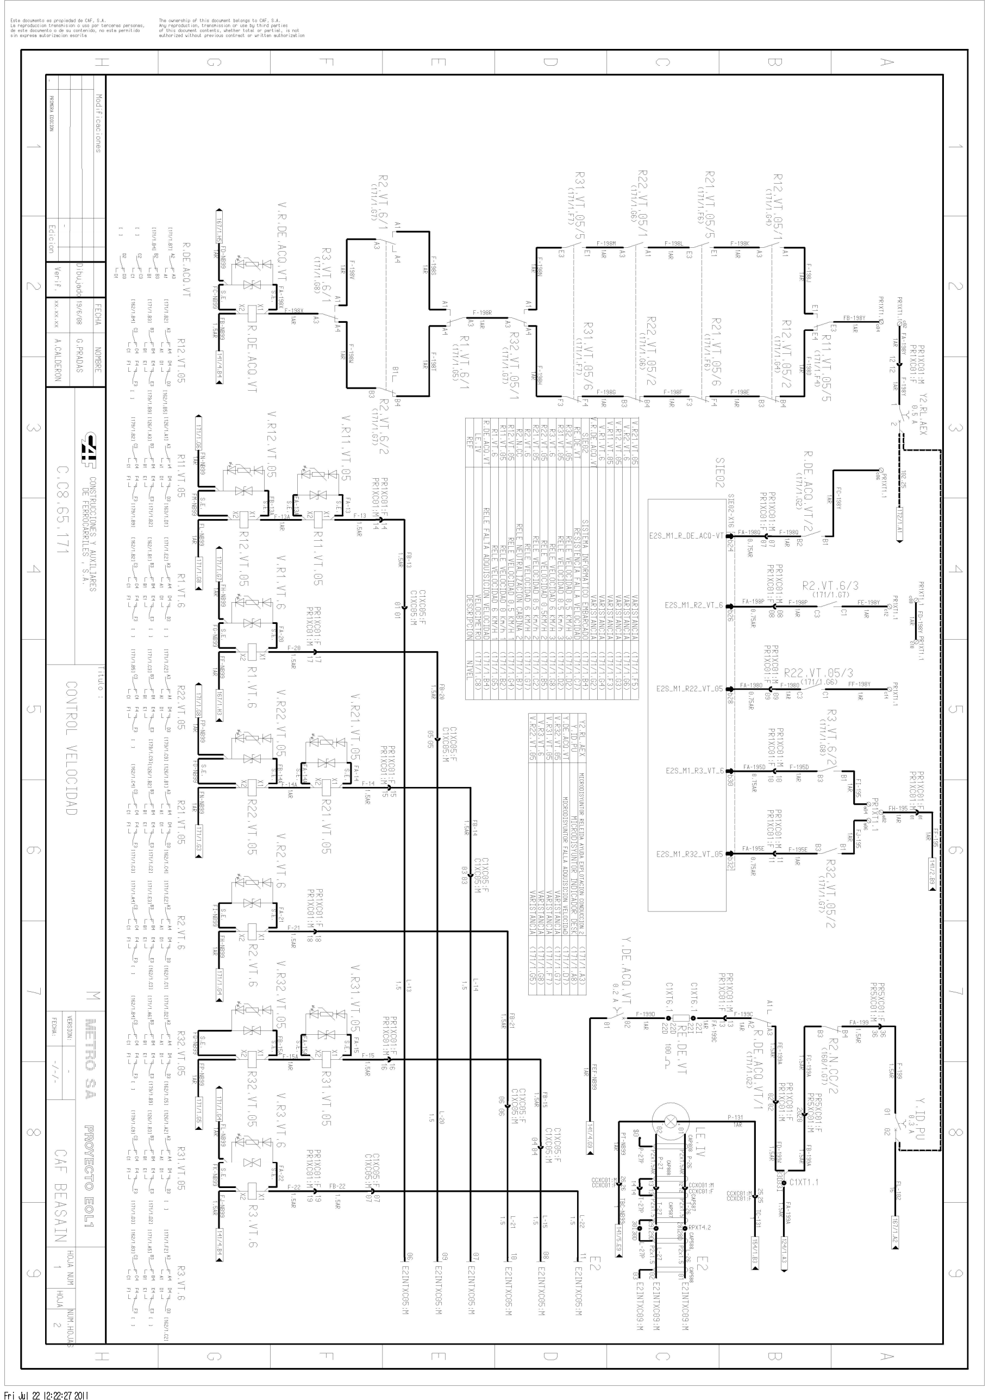
[picture p22: page 1]
