IgnGGA/cafProyect01/Info/planos/C.C8.65.177_H1_--+++REGISTRADOR_EVENTOS.pdf

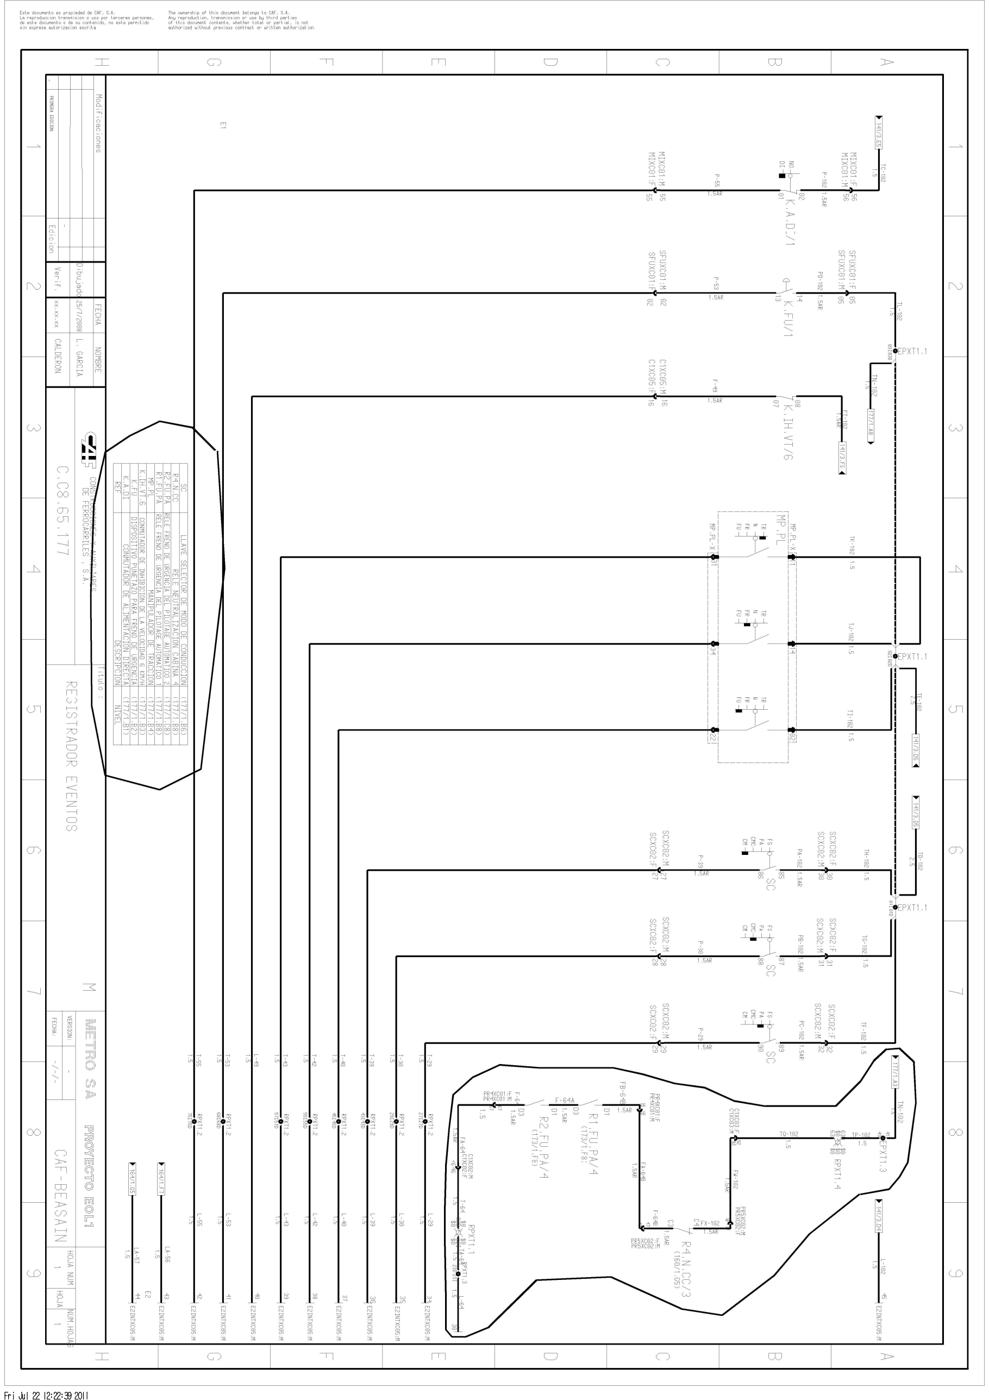
[picture p23: page 1]
