IgnGGA/cafProyect01/Info/planos/C.C8.65.871_H1_--+++CONTROL_VELOCIDAD.pdf

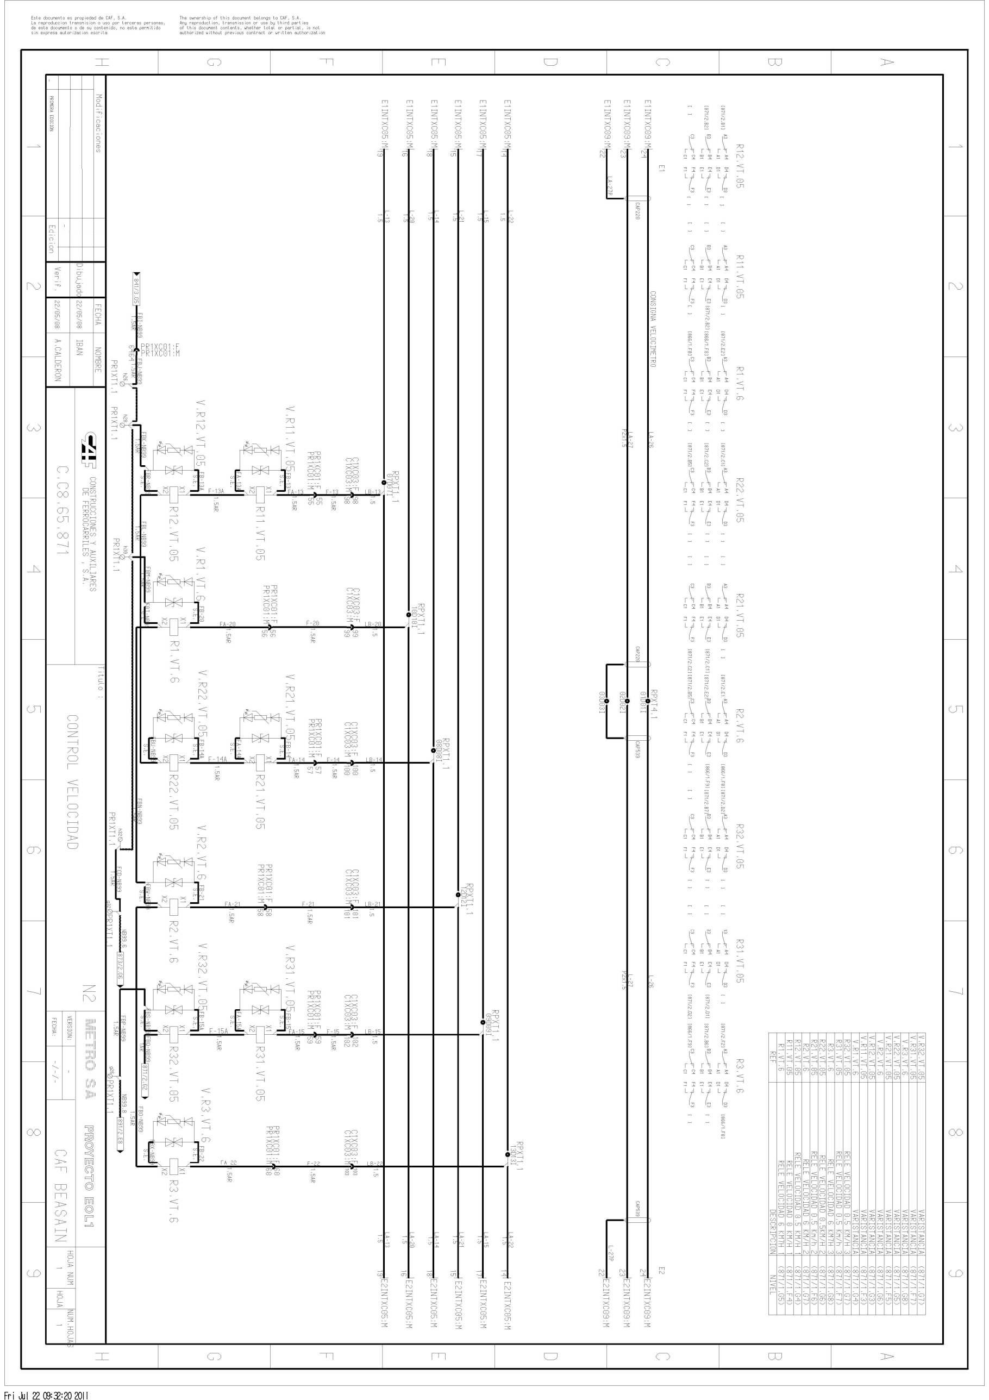
[picture p24: page 1]
