IgnGGA/cafProyect01/Info/planos/C.C8.65.871_H2_--+++CONTROL_VELOCIDAD.pdf

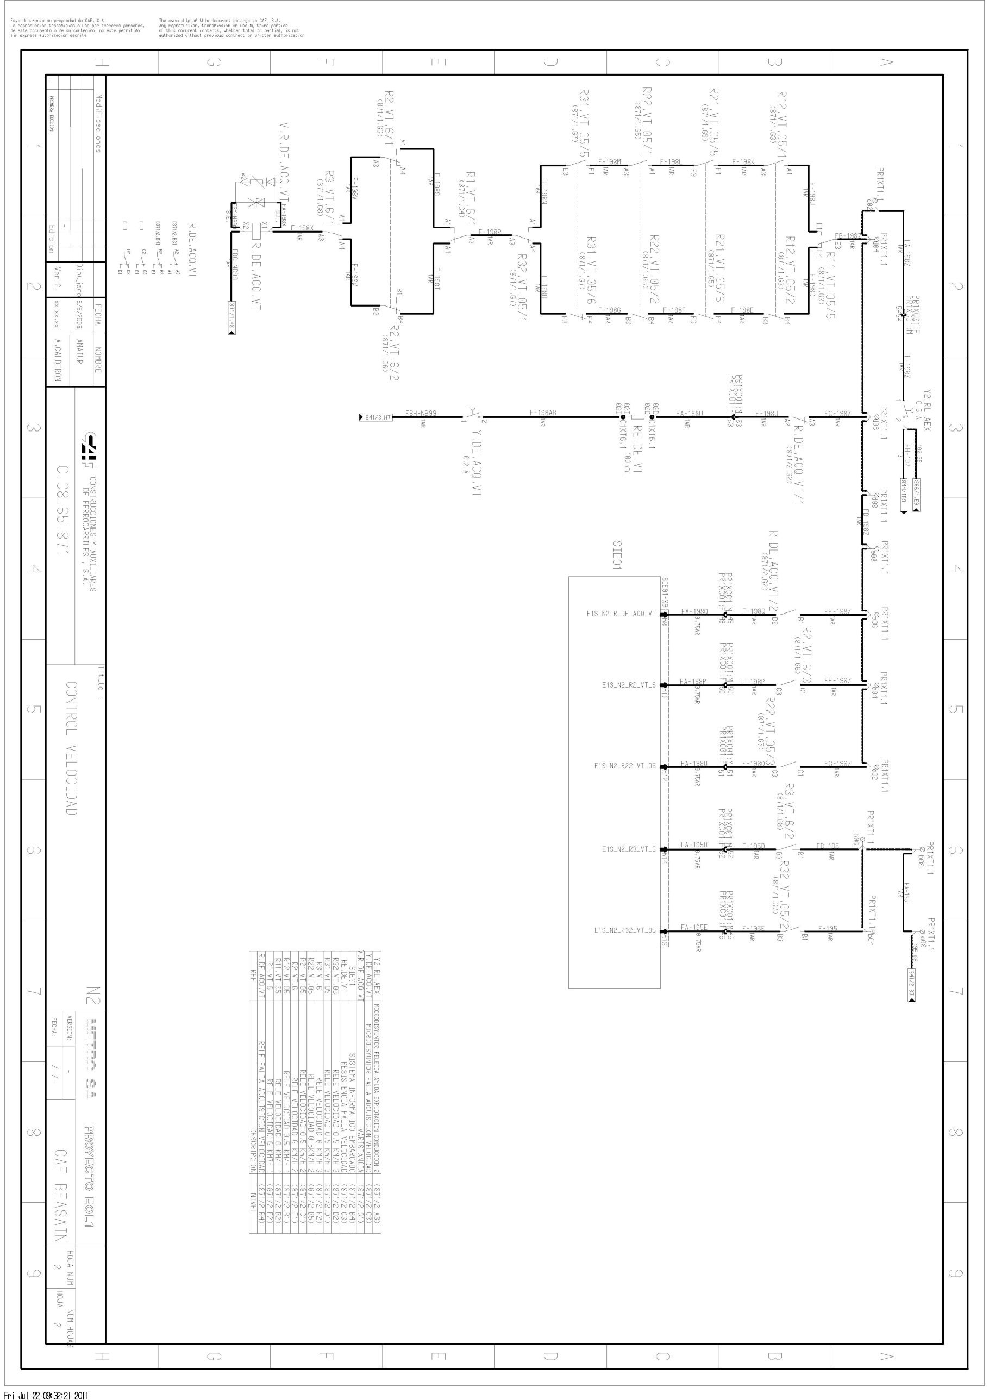
[picture p25: page 1]
