IgnGGA/cafProyect01/Info/planos/D.54.65.471_H1_--+++CONTROL_VELOCIDAD.pdf

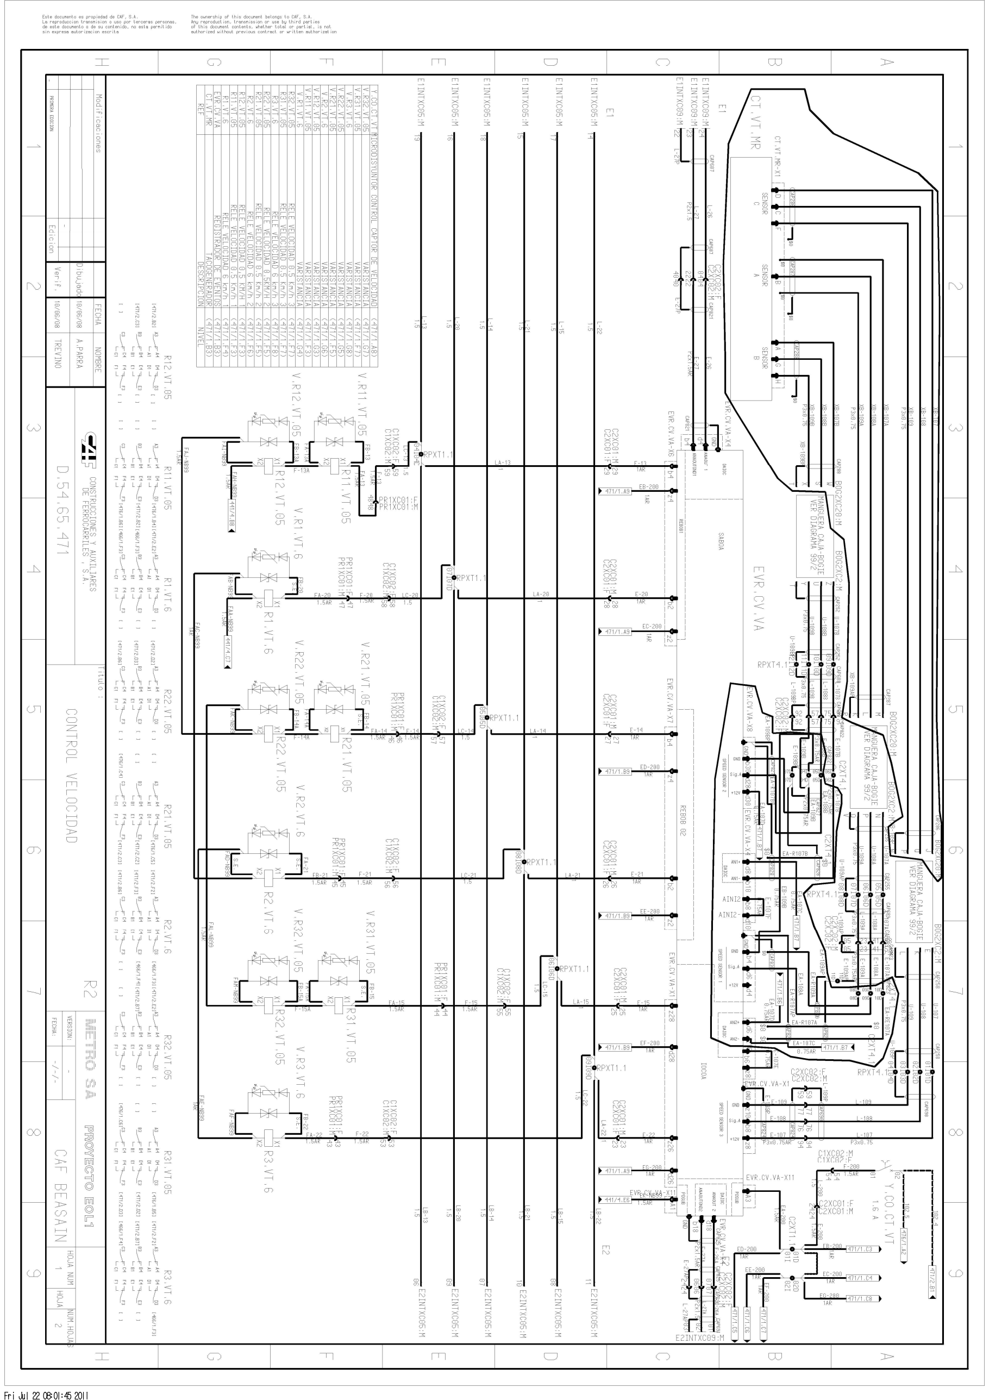
[picture p26: page 1]
