IgnGGA/cafProyect01/Info/planos/D.54.65.471_H2_--+++CONTROL_VELOCIDAD.pdf

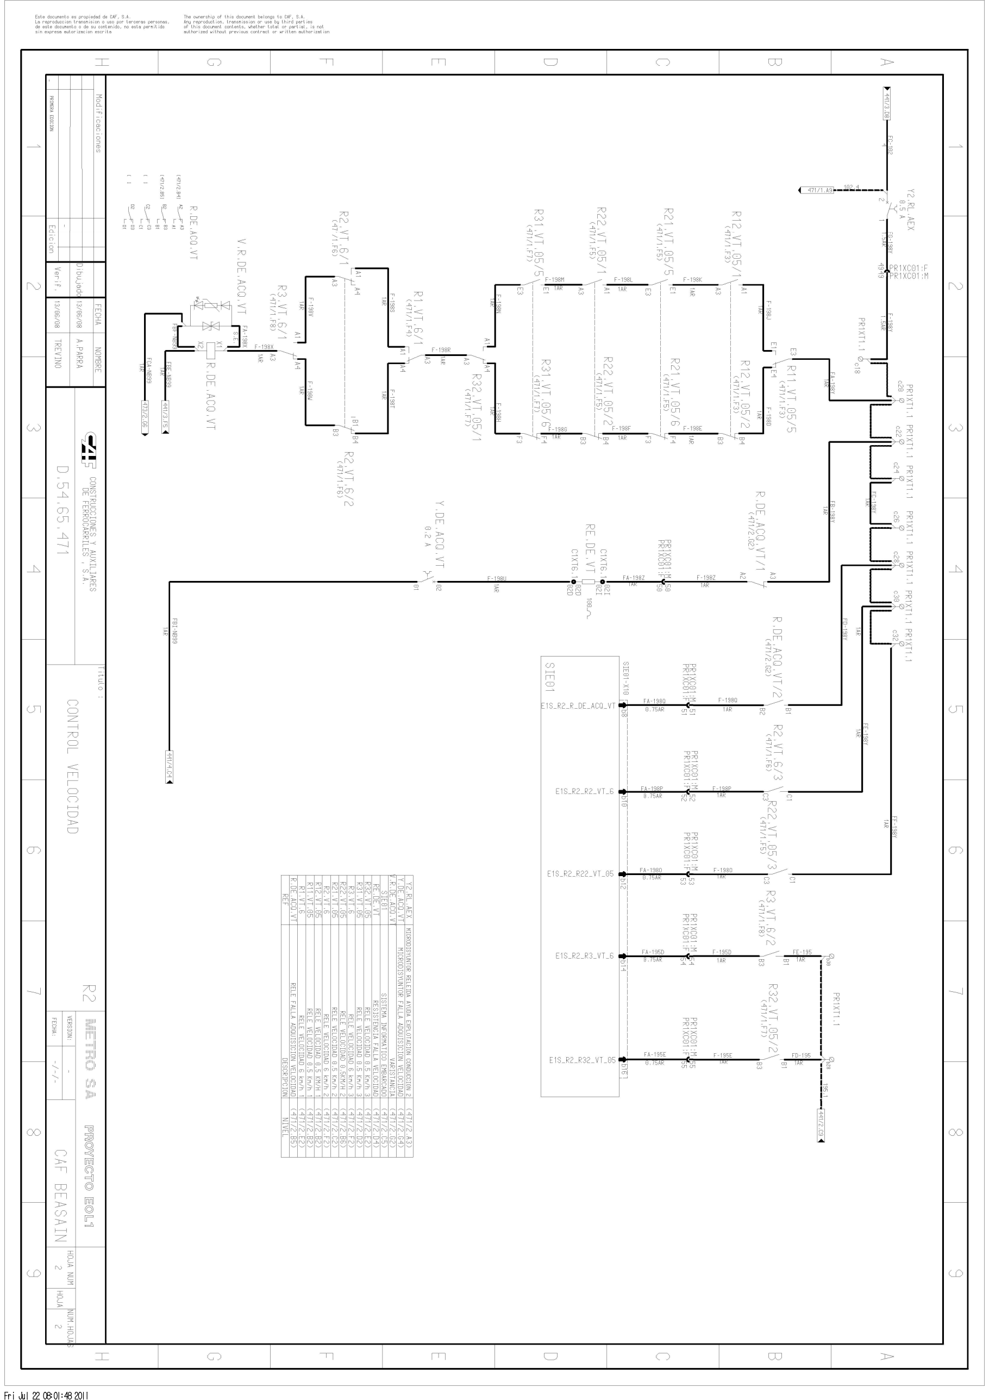
[picture p27: page 1]
