IgnGGA/cafProyect01/Info/planos/D.54.65.477_H1_--+++REGISTRADOR_EVENTOS.pdf

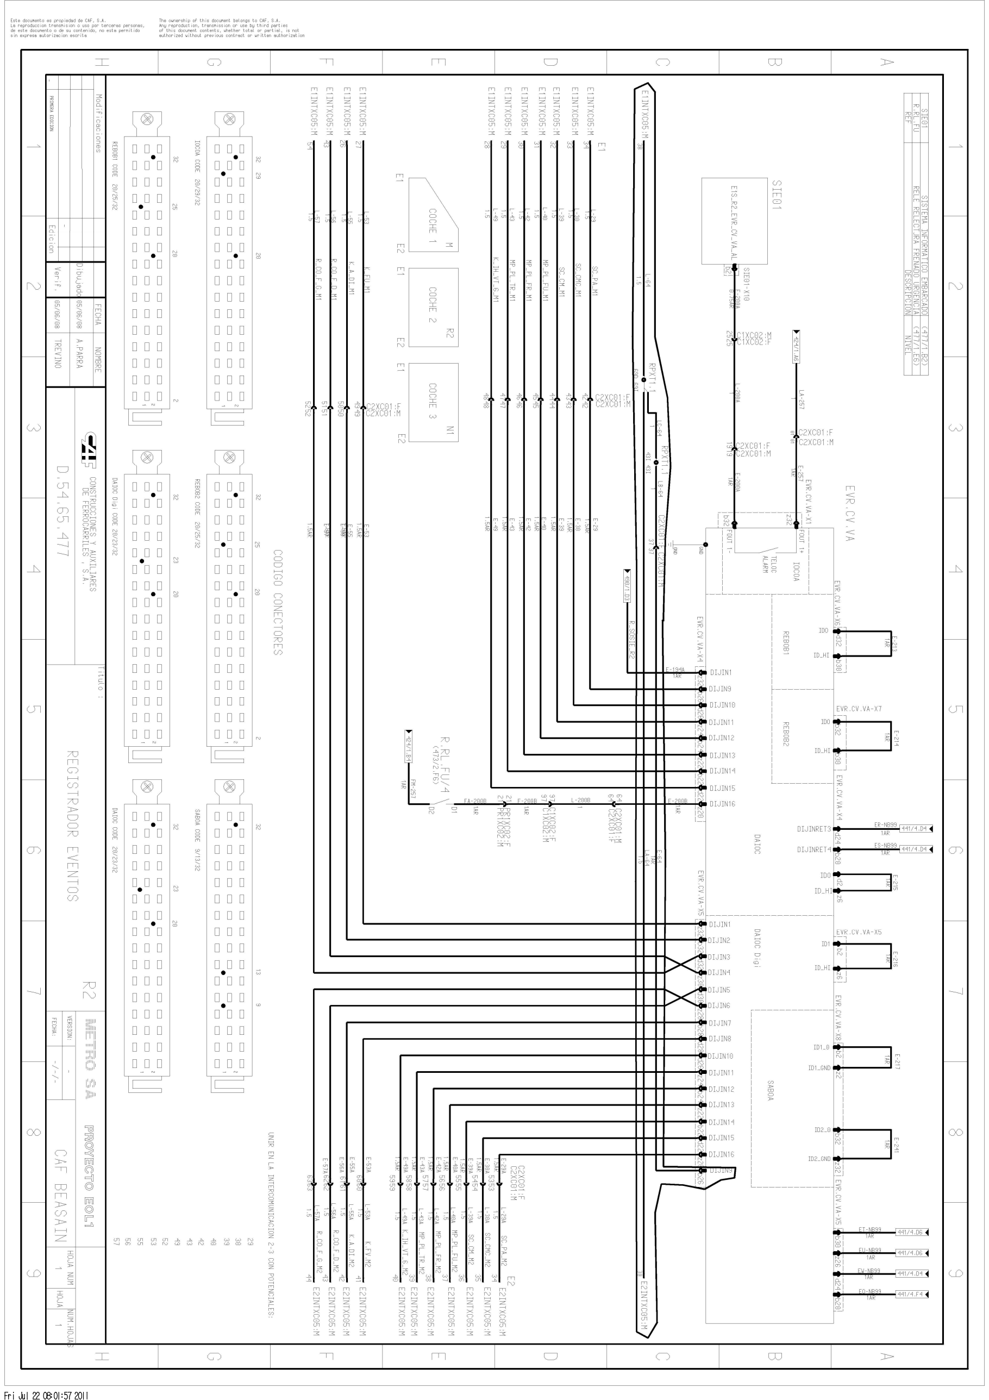
[picture p28: page 1]
