IgnGGA/cafProyect01/paraDiseñoPCB/simuladorPulsos/diseñoVersion01.pdf

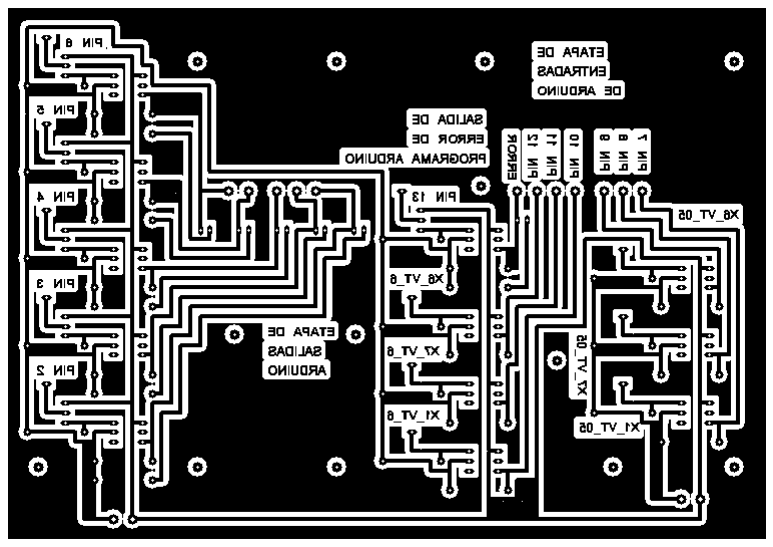
[picture p29: figure]
