IgnGGA/cafProyect01/IMAGE/paraManual_009.png

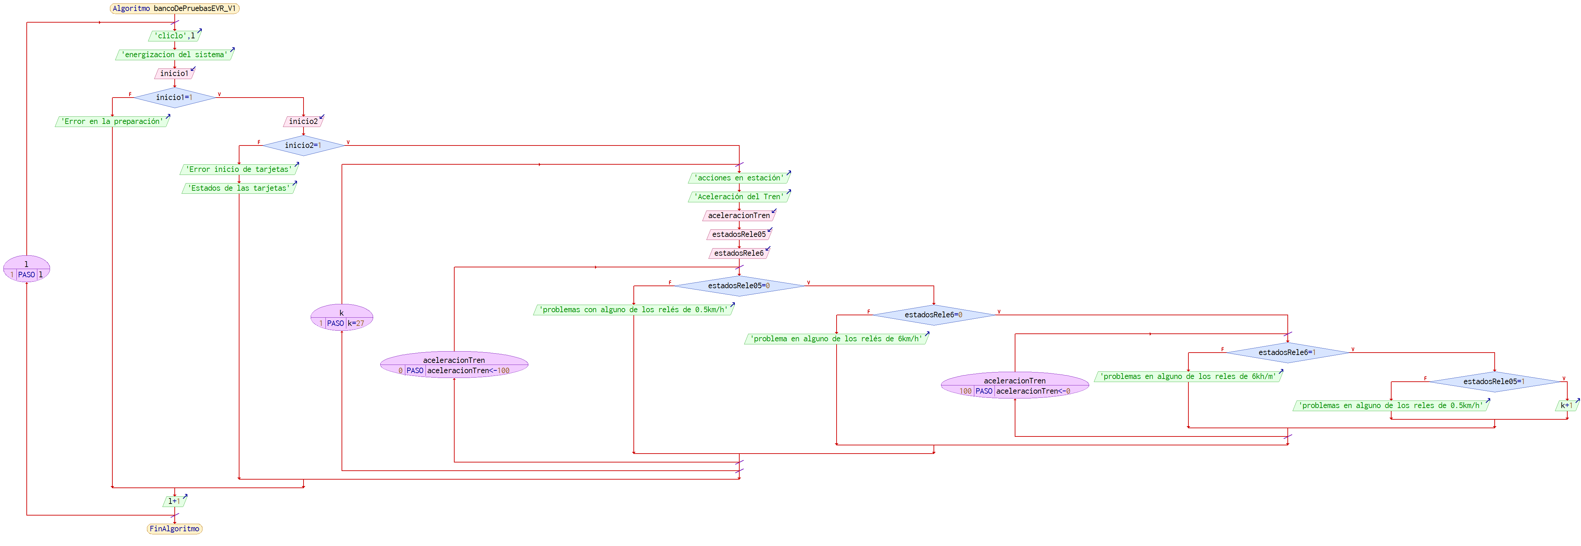
IMAGE/paraManual_009.png
