IgnGGA/cafProyect01/Info/planos/C.C8.65.471_H1_--+++CONTROL_VELOCIDAD.pdf

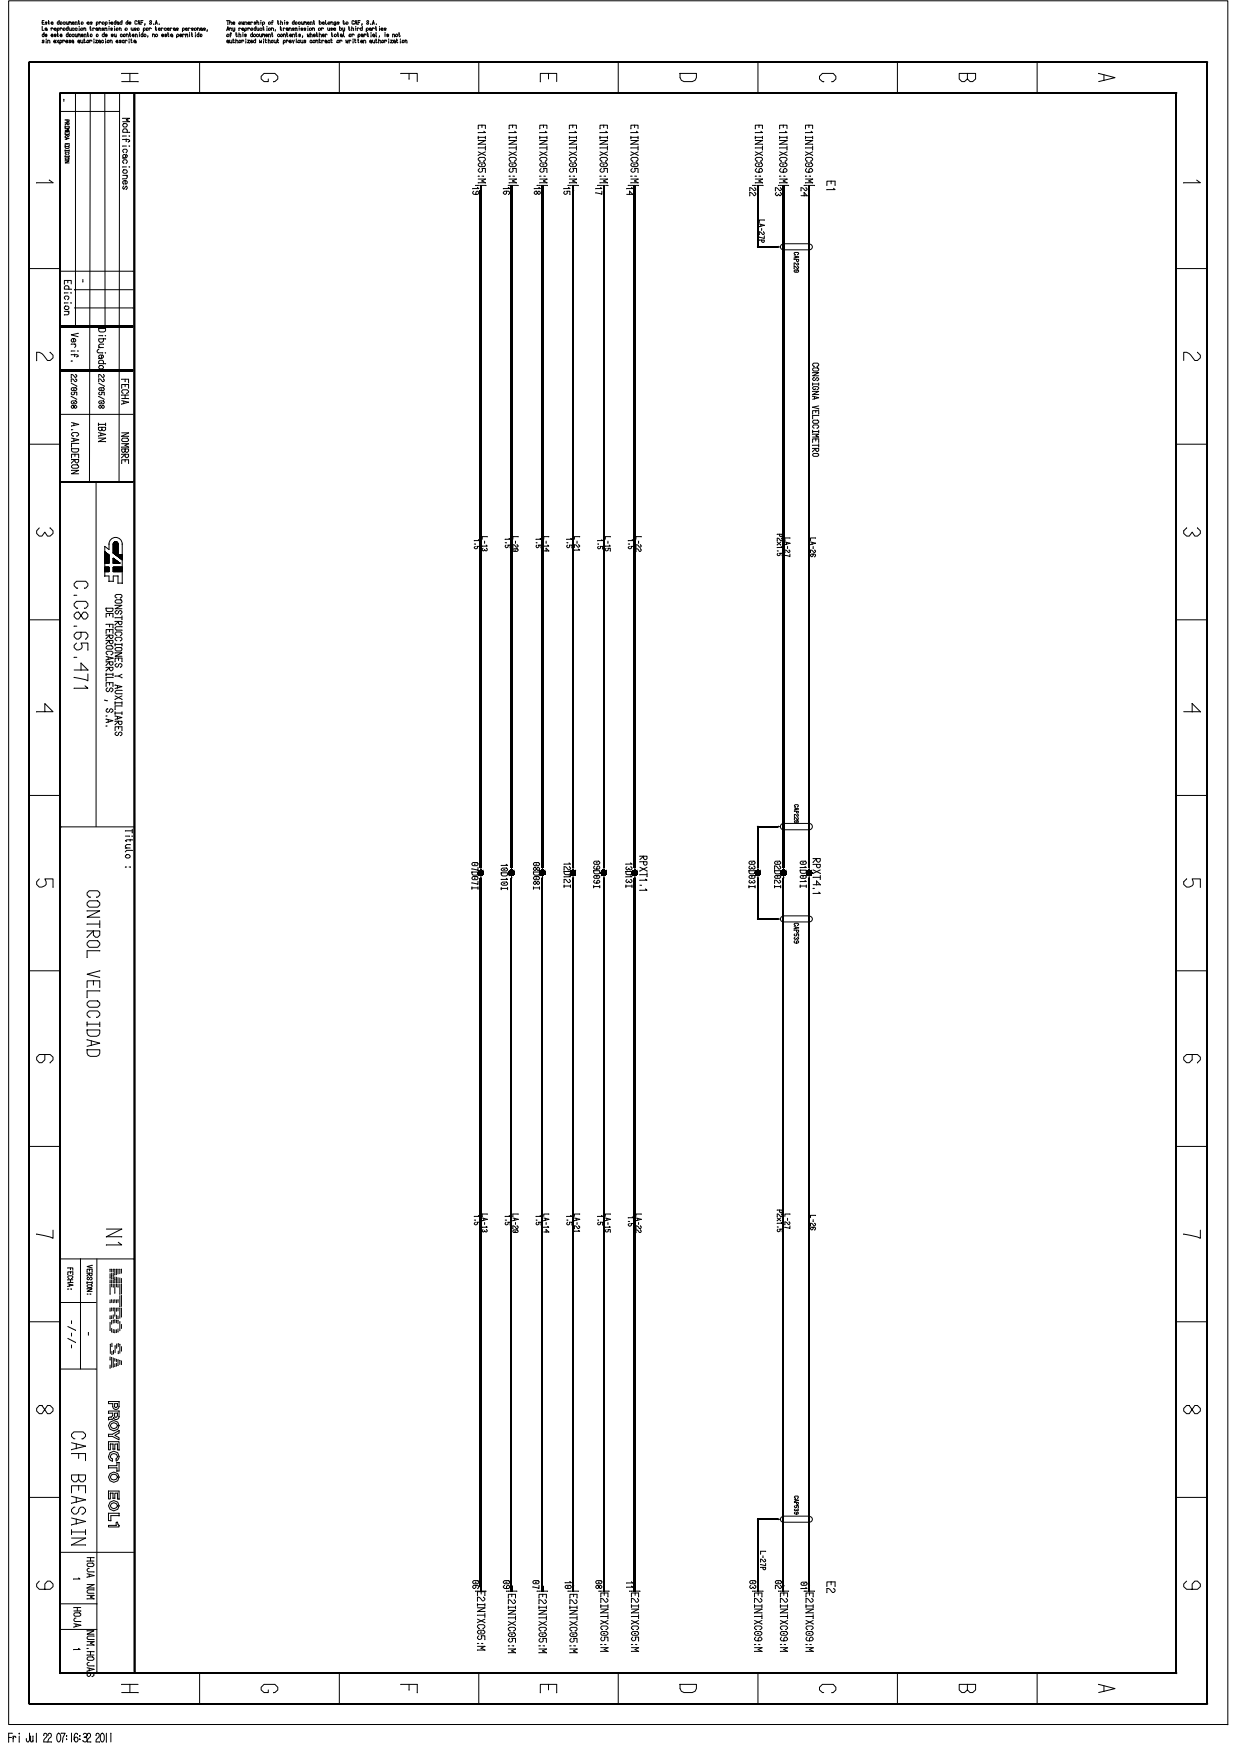
[picture p44: page 1]
