IgnGGA/cafProyect01/Info/planos/C.C8.65.477_H1_--+++REGISTRADOR_EVENTOS.pdf

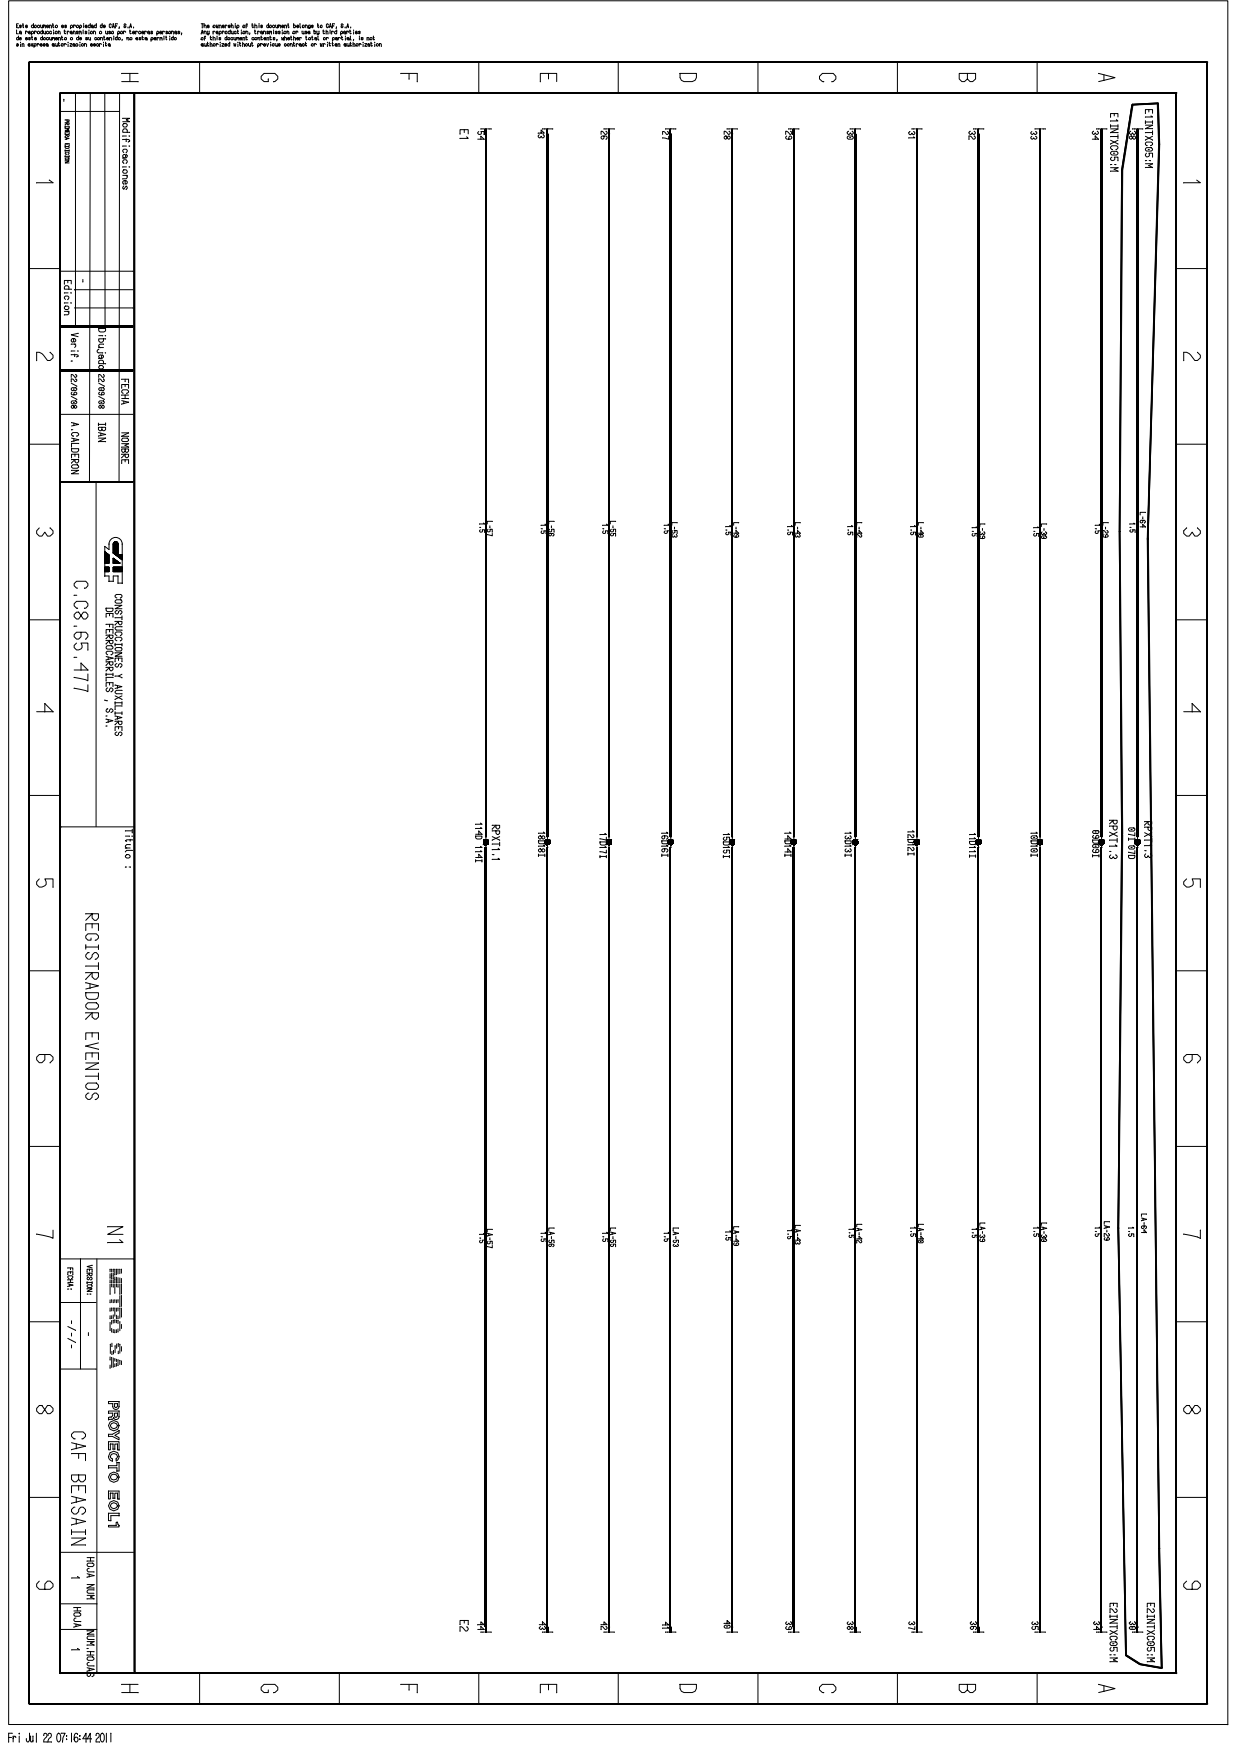
[picture p45: page 1]
