IgnGGA/cafProyect01/Info/planos/C.C8.65.877_H1_--+++REGISTRADOR_EVENTOS.pdf

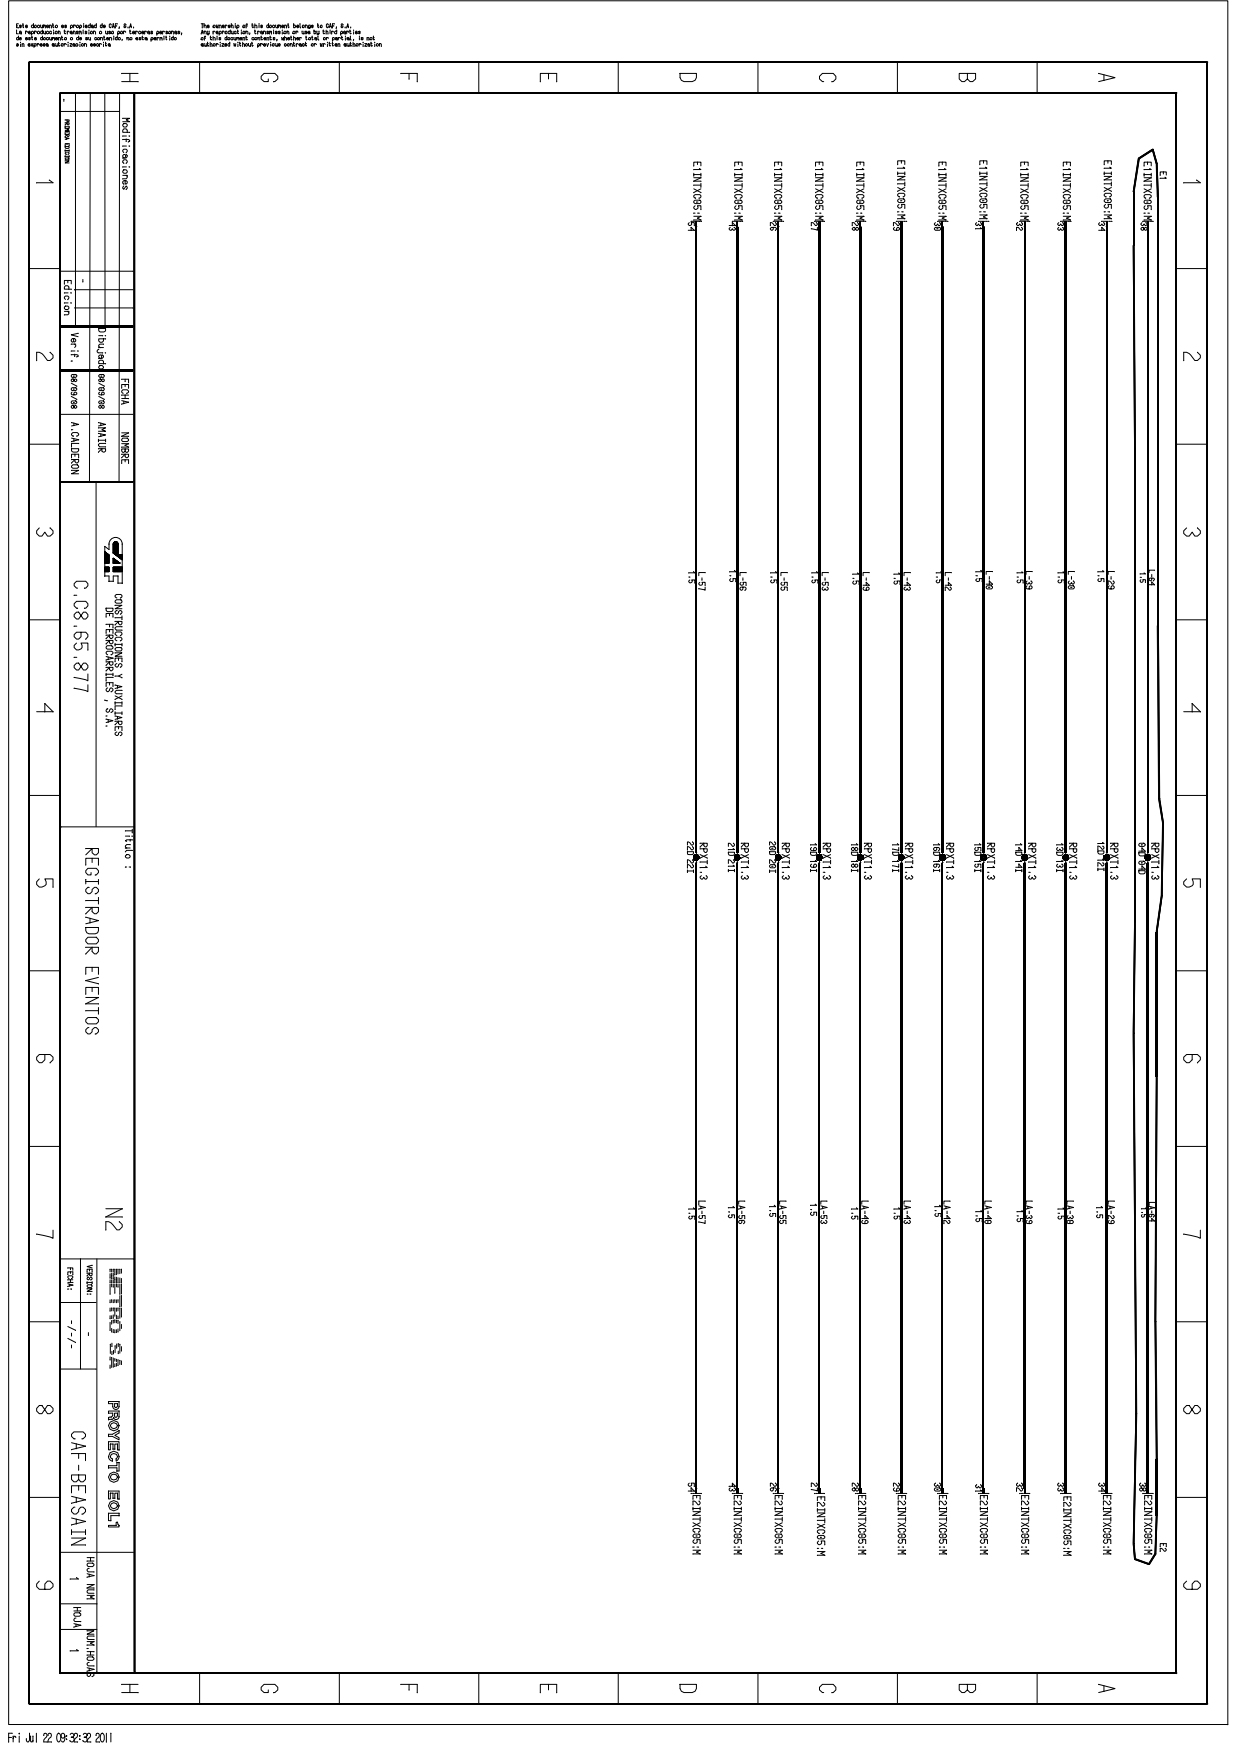
[picture p46: page 1]
