IgnGGA/cafProyect01/Info/planos/D.54.65.177_H1_--+++REGISTRADOR_EVENTOS.pdf

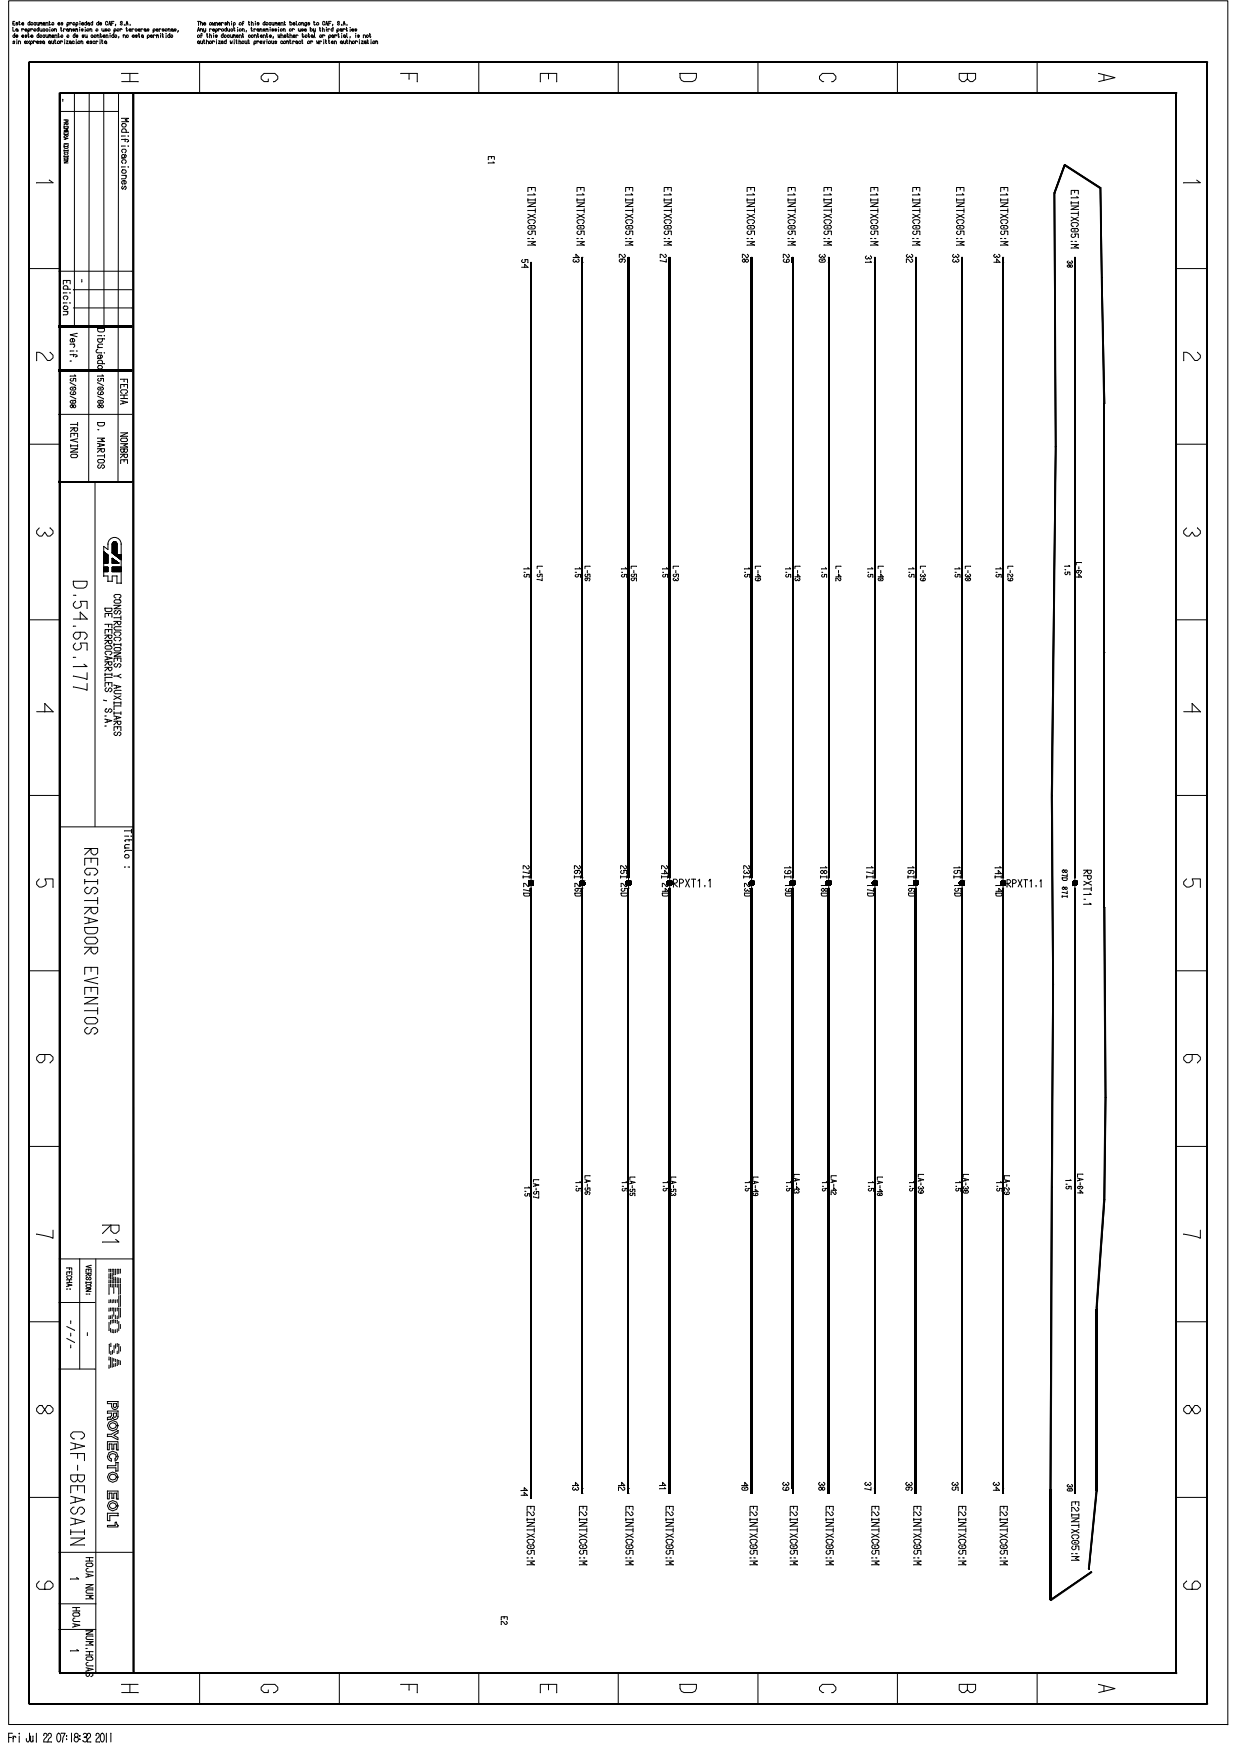
[picture p47: page 1]
