IgnGGA/cafProyect01/paraDiseñoPCB/simuladorPulsos/diseñoVersion02.pdf

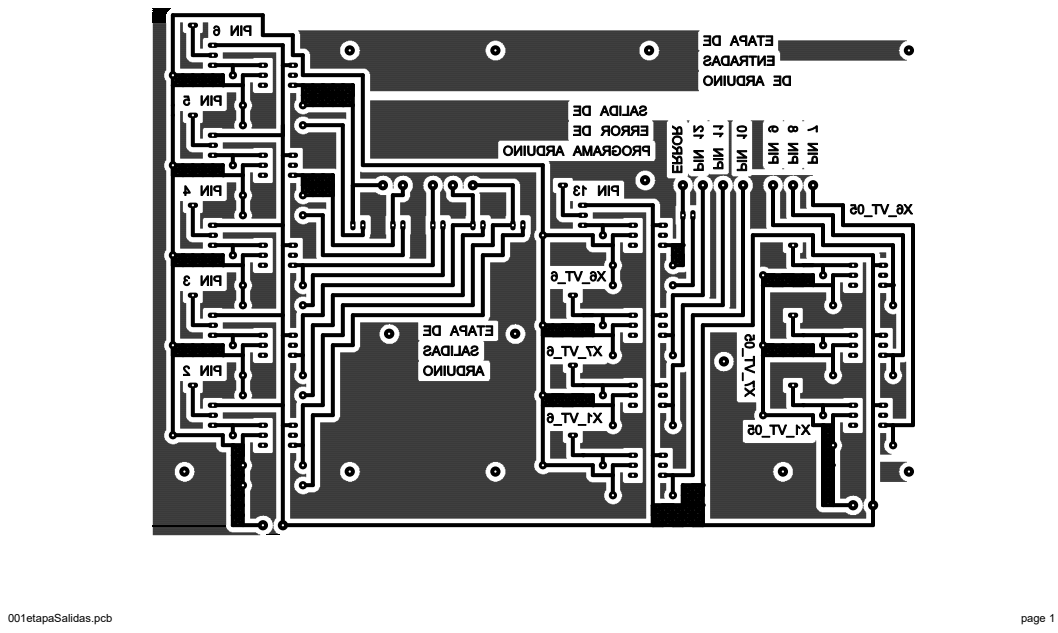
[picture p48: page 1]
001etapaSalidas.pcb; page 1 of 1
