IgnGGA/cafProyect01/(list of files, drawings)

Other design files:
generadorDePulsos/generadorDePulsost.pdsprj
paraDiseñoPCB/display/displayWithPIC.pcb
paraDiseñoPCB/simuladorPulsos/001etapaSalidas.pcb
paraDiseñoPCB/simuladorPulsos/diseñoPlacaVersion01.pcb
paraDiseñoPCB/simuladorPulsos/diseñoPlacaVersion02.pcb
proteus/arduinoUnoSimuladorVelocidad/simPulsosVelcidad_011.pdsprj
proteus/displayPic16f628A/display.pdsprj
