IgnGGA/cafProyect01/(commit log)

2021-04-14 Se utilizaran las 6 entradas analogicas del ARDUINO UNO como pines digitales; de esta manera trabajar en conjunto con el PIC 16F628A para proyectar mensajes de error en un DISPLAY
2021-04-14 se establecen las condiciones para que se muestren los mensajes establecidos en el programa
2021-04-14 Se establece programa capaz de enviar mensajes al display pendiente de combinacional del arduino para especificar con mas detalle los ERRORES
    [simPulsosVelcidad_011.pdsprj]
2021-04-14 se crean logica combinacional para los errores segun casos
    [cafProyect01.ino]
2021-04-15 se inicia diseño placa display, se cargara programa en el pic 16f628A y se conectara al display 20x4, a espera de resultados y comentarios. El arduino y su programacion quedan sin cambios hasta el mo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
    [001etapaSalidas.pcb, diseñoPlacaVersion01.pcb, diseñoPlacaVersion02.pcb, display.pdsprj, displayWithPIC.pcb, simPulsosVelcidad_011.pdsprj]
2021-04-15 se cargo programa a PIC con PICKIT3 PROGRAMMER y este cargo sin problemas, no obstante al montar el integrado a la protoboard este no realiza la tarea programada, quedando la pantalla sin actividad; 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
2021-04-15 se reconstruye el programa del pic, para asegurar funcionamiento y subida al microcontrolador
2021-04-15 se corrige programa del pic para intentar que el microcontrolador reconozca las variables y asi ejecutar funciones
2021-04-15 se contruye y crea el programa para pic, eliminando el comportamiento standar de los puertos A
2021-04-15 Se modifica el programa de funcionamiento del pic para verificar funcionamiento de este, no asi no se obtienen los resultados esperados, recordar hablar con profesor para poder ver esta situacion
2021-04-15 se acomodo el programa para volver a ser funcional
2021-04-16 modificacion programa ayuda de regalon, esperemos que funcione
    [display.pdsprj]
2021-04-16 actualizacion programa y complicacion de este para obtener formato hex para su carga en el PIC seleccionado, a espera de resultados
2021-04-16 programa para pic es funcional, el error aparente es de corriente suministrada por la fuente de ese entonces, que era el computador, al ser conectada a una externa este funciono sin problemas, no obs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
2021-04-16 diseño de placa del PIC para la comunicacion entre arduino y pantlla LCD para ser impreso y lanzado al acido, para si perforacion y montaje de componentes.
    [displayWithPIC.pcb]
2021-04-17 se elimina los Serial print y read, tambien se vuelve el programa de 1.25 a 2.5 veces la frecuencia de trabajo para los arreglos matematicos para hacer la duracion del programa de un minut aprox, red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
    [cafProyect01.ino]
2021-04-17 correccion programa PIC en terminales B para pines E/RS/RW ya que el pictograma estaban desafasados en un pin cada uno correspondientemente, a espera de prueba de simulacion para su visto bueno, carg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
2021-04-19 se restablece el programa a su version anterior
2021-04-22 se corrige programa en funcion a el nuevo diseño de placa, se conservan los seriales, este programa hasta este punto es la version definitiva para hacer uso del él
    [cafProyect01.ino]
2021-04-26 se cambio la variable Z por var3
2021-04-26 se guarda nueva version del diseño de la placa, considerar que falta relacionar las tierras de los optoacopladores de la etapa control con el sistema de 12V
2021-04-28 se corrigen mensajes que envia el arduino y el display al usuario
    [cafProyect01.ino]
2021-04-29 se crea documento con informacion general del funcionamiento del banco de pruebas de HASLER
2021-05-04 se crea el archivo diagrama.docx el cual contiene informacion de funcionamiento del banco de pruebas
2021-05-04 se generan las funciones de inicio, en la preparacion del sistema, donde el EVR envia pulsos para probar su funcionamiento, antes de entrar a realizar funciones, considerando el funcionamiento inicia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
    [cafProyect01.ino]
2021-05-04 compilacion de los programas, no detectan errores en los sistemas, de tal manera que su funcionalidad no presenta fallas aparentes, hasta que la prueba sea realizada y superada eficazmente
    [cafProyect01.ino]
2021-05-13 se actualiza tiempo de fncionamiento de la preparacion del progrmama de artuino de 10s a 13s, de igual forma se corrigen los mensajes de errores del display
    [cafProyect01.ino]
2021-06-16 se crean a función star con un delay de 3s, y se cambia la energizacion del display de 5v a a4, de igual forma se modifica fisicamente el voltaje de entrada de los pulsos al arduino de 12v a 5, tambi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
2021-06-17 se agregar visualizador serial para los estados de las entradas x1vt05, x1vt6 y x6vt05, para analizar el inicio del programa.
2021-06-23 se omiten funcion okay y mensaje de evaluacion de instancia 2, considerando las pruebas del dia 22/06/2021, se crearan algunas funciones, como espera de respuestas necesarias. Como analisis de esto, 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
2021-06-23 se cambia la variable luz por S1S_R2_TEST_VA con tal de enviar la respuesta esperada a la SIE R2, para confirmar el funcionamiento de lso 2/3
2021-07-13 actualizacion de avances de proyecto
    [111_V2.xls, NOT_DEF.xls, estadoVariablesEInfo.xlsx]
2021-07-15 el programa cafProyect01.ino es el que se encuentra cargado actualmente en la placa del TEST.EVR, actualmente con las modificaciones realizadas el sistema en si es funcional, obteniendo como resultad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
    [generadorDePulsost.pdsprj]
2021-07-30 se agrega contador de viajes
2021-08-03 programa actual en arduino, con control de alimentacion de evr
2021-08-04 cod actual en arduino, banco de pruebas EVR, no se ejecuta la etapa de instancia 01, pendiente de revision
2021-08-05 se fuerza el reconocimiento de las etapas de instancias 01 y 02 al inicio del programa al encenderse el equipamiento
2021-08-05 el programa cafProyect01.ino es el actual subido en la placa, siendo funcional, con una durcion por sico de aproximadamene 4 segundos.
2021-08-09 se genera la condicion de precausion en caso de que las que no participan en el arranque del equipo se encuentren activas
2021-08-09 se corrige el tiempo de espera de 6 a 7 segundos
    [cafProyect01.ino]
2021-08-09 se genera funcionalidad para agregar alamra sonota de 72v
2021-08-10 se crea la funcion testEVR el cual integra las funciones para la realizacion de las pruebas desde el encendido hasta el apagado del sistema
2021-08-10 se genera un contador de errores encontrados, despues de avisadas las alarmas se realizaran hasta 3 pruebas, luego se indicara revisar los errores en caso de encontrarse alguno.
    [cafProyect01.ino]
2021-08-10 si se encuentran 3 errore, el sistema dara la advertencia y apagara el sistema
    [cafProyect01.ino]
2021-08-10 se realiza funcion de apagado y encendido de pantalla
2021-08-10 se crea visualizador serial via python para la comunicacion serial con arduino
2021-08-10 se genera ejecutable del monitor para realizar pruebas
2021-08-10 se corrige programa de arduino y mensajes seriales
    [cafProyect01.ino]
2021-08-10 el contador de ciclo, considera los errores como un ciclo, mediante l=l+m
    [cafProyect01.ino]
2021-08-10 se agrega exit(0) para finalizar el porograma una vez encontrados 5 errores
    [cafProyect01.ino]
2021-08-11 actualizacion manual de uso
2021-08-13 test para arduino con serial progrma
