IgnGGA/cafProyect01/IMAGE/008_armarioEVR_cocheR2.jpg

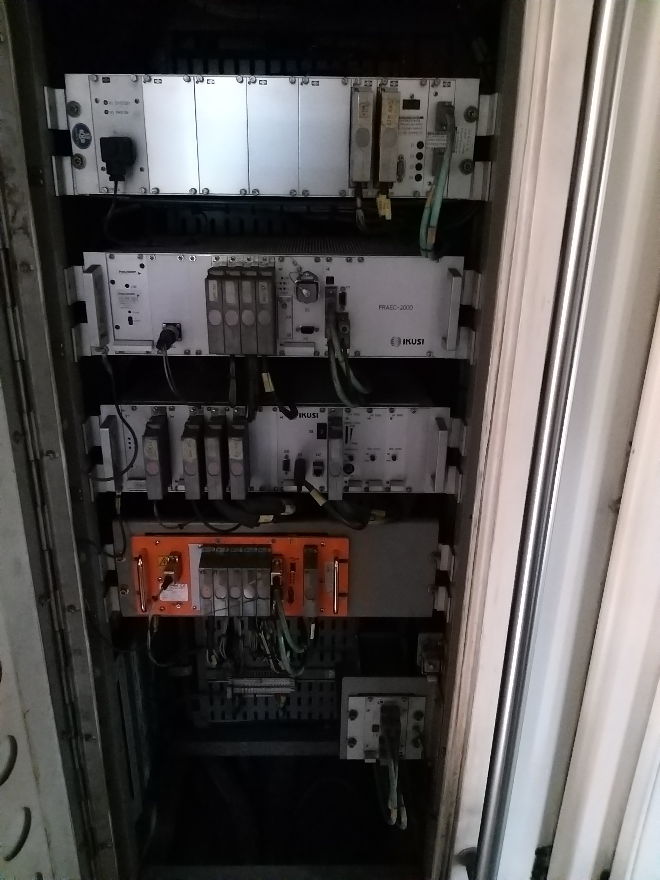
IMAGE/008_armarioEVR_cocheR2.jpg
